ThomHPL/ScanBook_2017/Documentation/mecanique/images-structures/IMAG0920.jpg

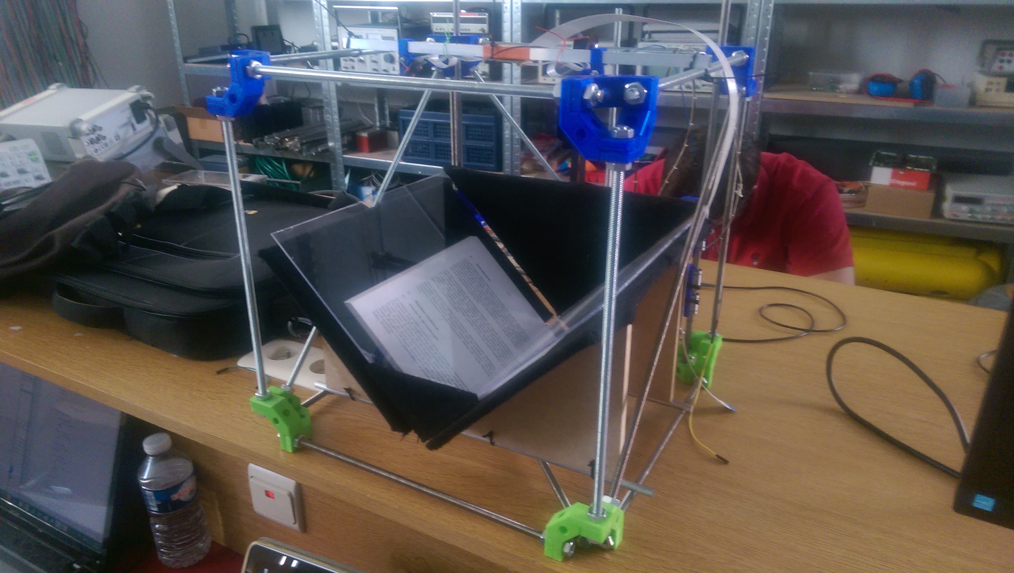
Documentation/mecanique/images-structures/IMAG0920.jpg
