ThomHPL/ScanBook_2017/Documentation/06_03/IMG_20170306_171104.jpg

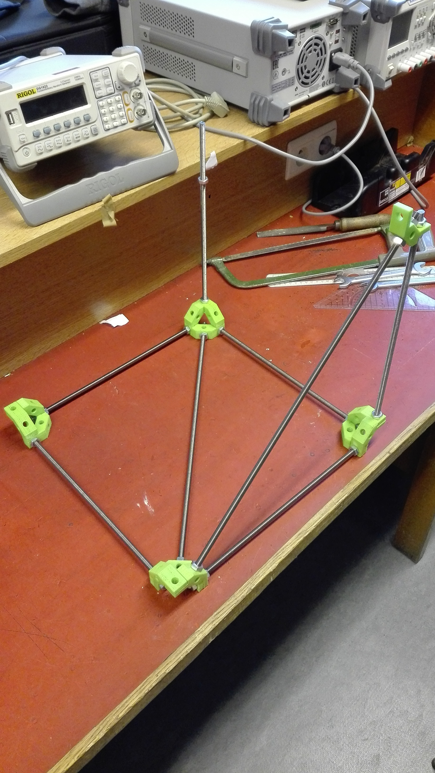
Documentation/06_03/IMG_20170306_171104.jpg
