ThomHPL/ScanBook_2017/Documentation/RF_SB_03_03_2017.docx

Projet et bureau d’étude

ScanBook

RedFlags

Thomas Herpoel – Wesley Estievenart – Michael Manzella

Work packages

WP | Description | Etat
SB_1 | Caméra : Choix, FOV, test,… | Green
SB_2 | Choix de la librairie de reconnaissance d’image et de l’algorithme (OCR) | Green
SB_3 | Programmation traitement des images | NC
SB_4 | Modification de la structure actuelle | Green
SB_5 | Conception d’un module de switch caméra (PCB) | Green
SB_6 | Circuit de protection (moteur pas à pas) | Green
SB_7 | Système d’éclairage indirect | NC
SB_8 | Programmation commande de moteur | Green
SB_9 | Interface homme machine | NC
SB_10 | Système d’alimentation | NC
SB_11 | Programmation Raspberry Pi (Configuration, Communication,…) | Yellow
