ThomHPL/ScanBook_2017/Documentation/03_03/renduHD.png

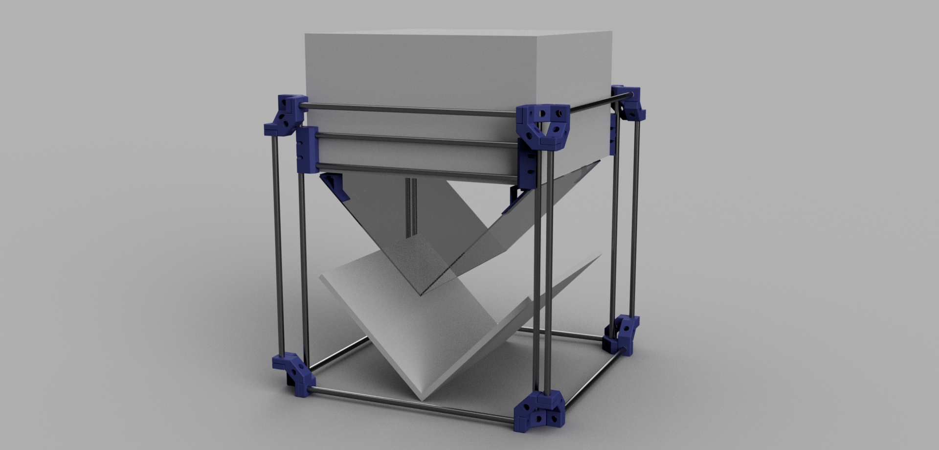
Documentation/03_03/renduHD.png
