ThomHPL/ScanBook_2017/Documentation/2017-03-28-133614_1920x1080_scrot.png

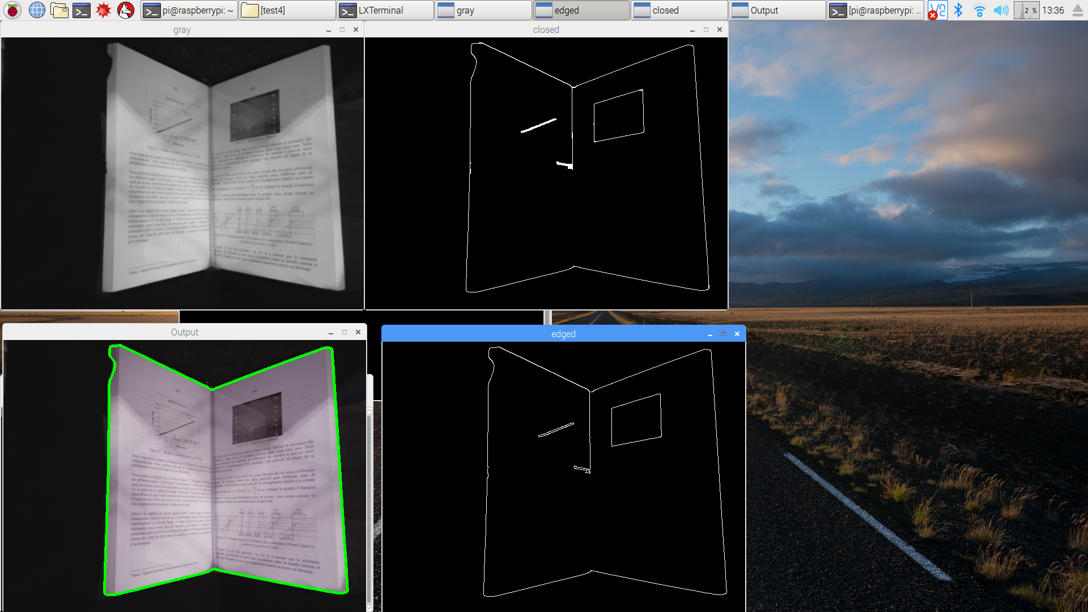
Documentation/2017-03-28-133614_1920x1080_scrot.png
