ThomHPL/ScanBook_2017/Documentation/electronique/A4988.PNG

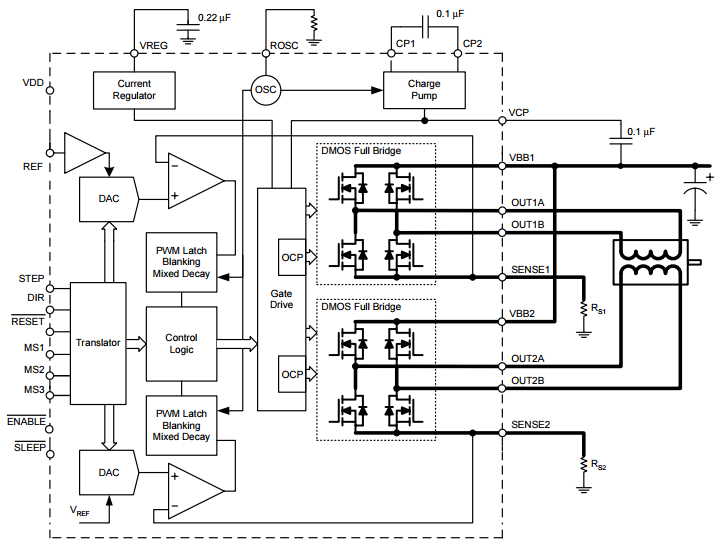
Documentation/electronique/A4988.PNG
