ThomHPL/ScanBook_2017/Documentation/electronique/PCB_top.PNG

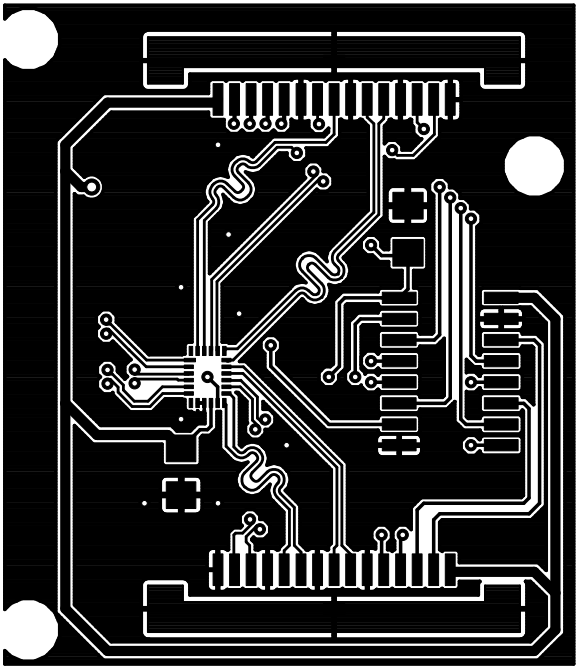
Documentation/electronique/PCB_top.PNG
