ThomHPL/ScanBook_2017/Documentation/mecanique/45_corner.PNG

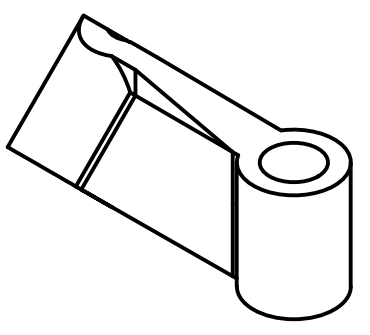
Documentation/mecanique/45_corner.PNG
