ThomHPL/ScanBook_2017/Documentation/mecanique/fin de course bas.PNG

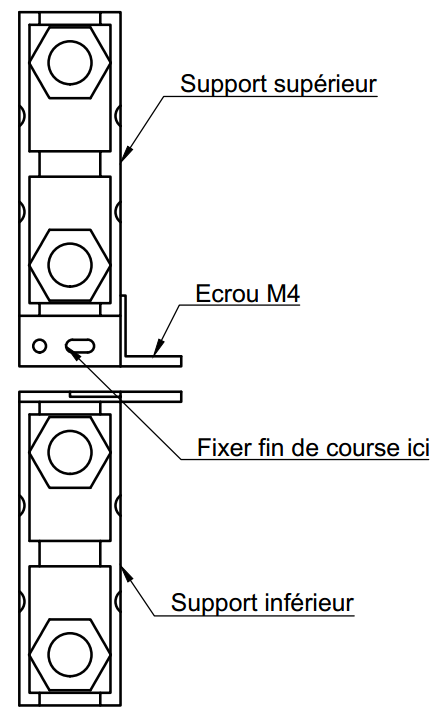
Documentation/mecanique/fin de course bas.PNG
