ThomHPL/ScanBook_2017/Documentation/mecanique/images-structures/IMAG0921.jpg

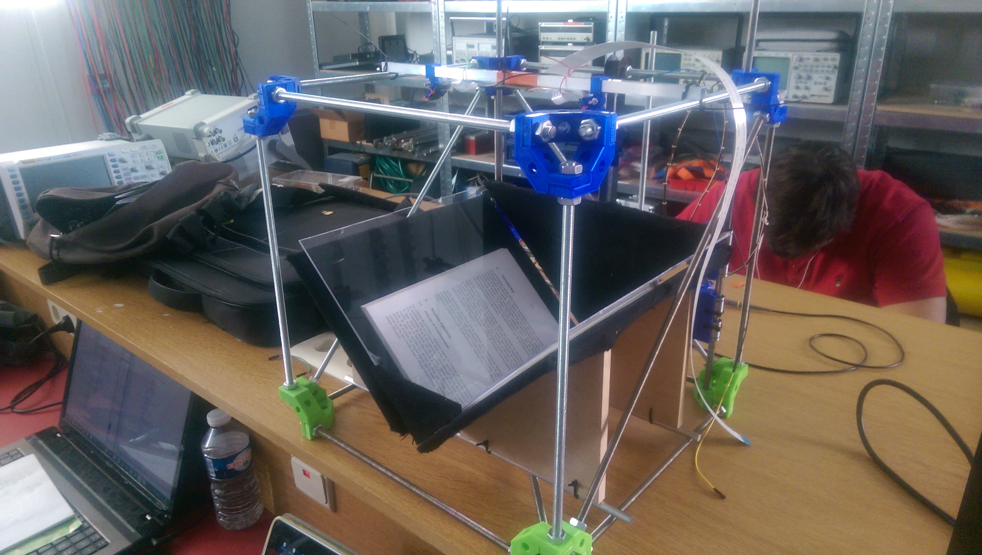
Documentation/mecanique/images-structures/IMAG0921.jpg
