ThomHPL/ScanBook_2017/Documentation/mecanique/images-structures/IMAG0922.jpg

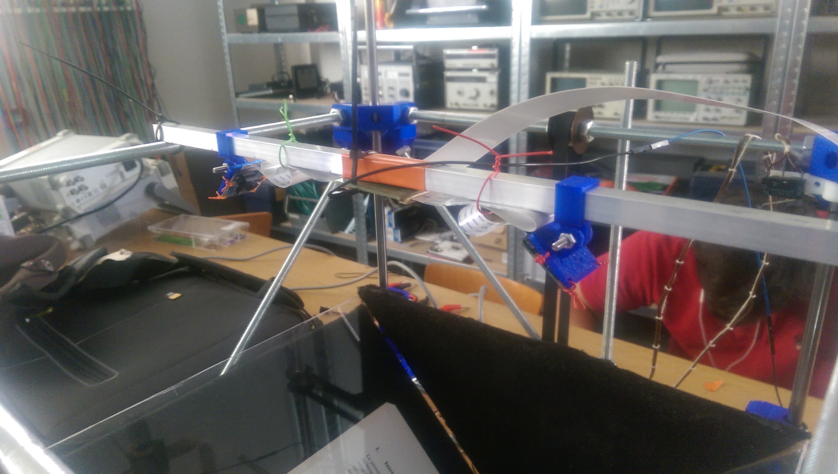
Documentation/mecanique/images-structures/IMAG0922.jpg
