ThomHPL/ScanBook_2017/Documentation/mecanique/images-structures/IMAG0923.jpg

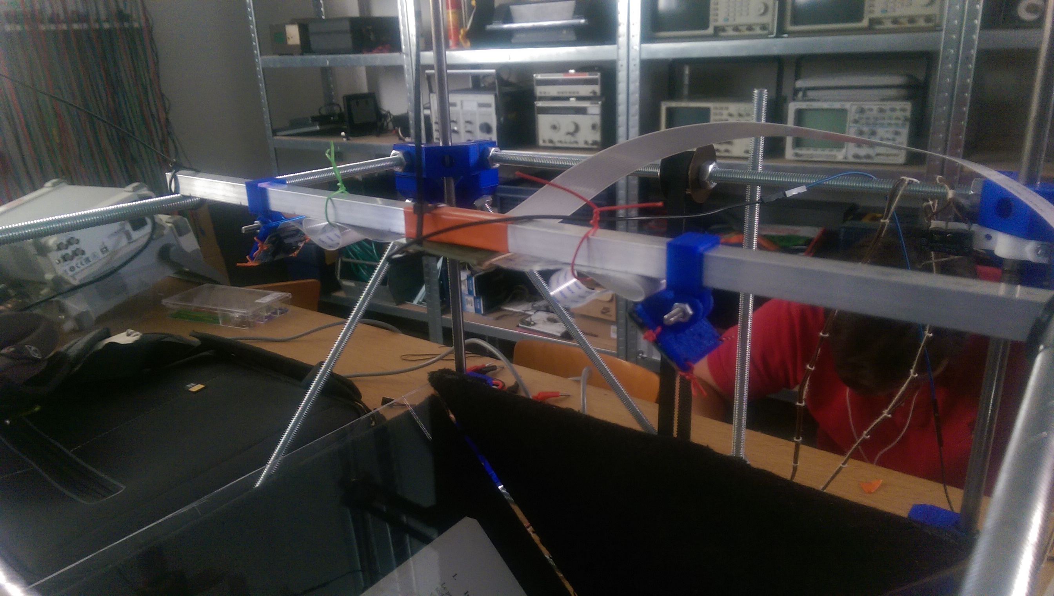
Documentation/mecanique/images-structures/IMAG0923.jpg
