ThomHPL/ScanBook_2017/Documentation/mecanique/images-structures/IMAG0924.jpg

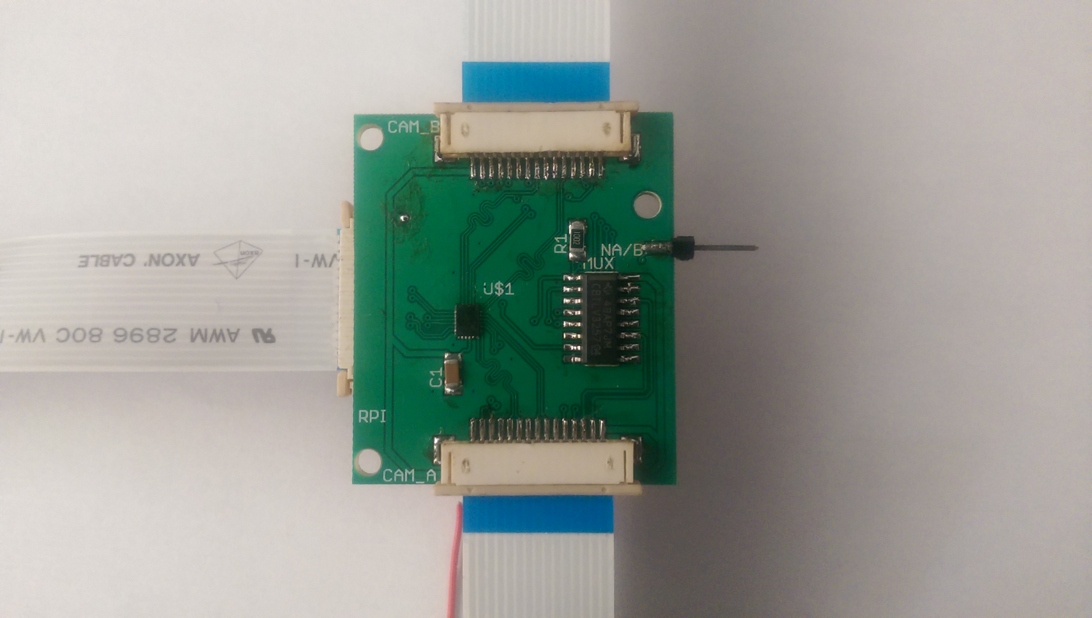
Documentation/mecanique/images-structures/IMAG0924.jpg
