ThomHPL/ScanBook_2017/Documentation/mecanique/images-structures/IMAG0925.jpg

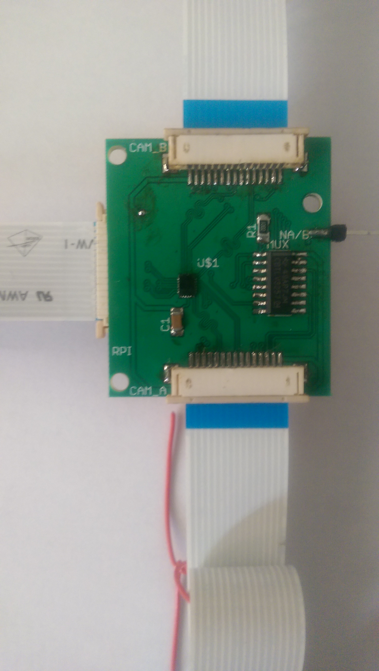
Documentation/mecanique/images-structures/IMAG0925.jpg
