ThomHPL/ScanBook_2017/Documentation/mecanique/images-structures/IMAG0926.jpg

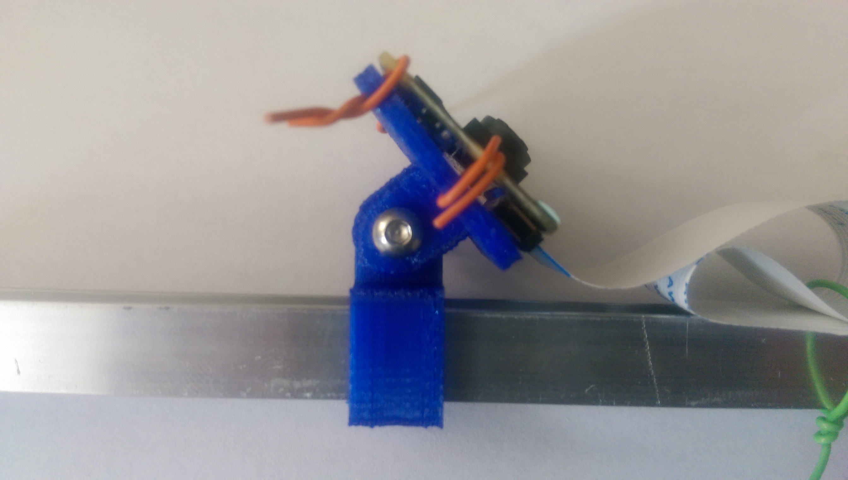
Documentation/mecanique/images-structures/IMAG0926.jpg
