ThomHPL/ScanBook_2017/Documentation/mecanique/images-structures/IMAG0927.jpg

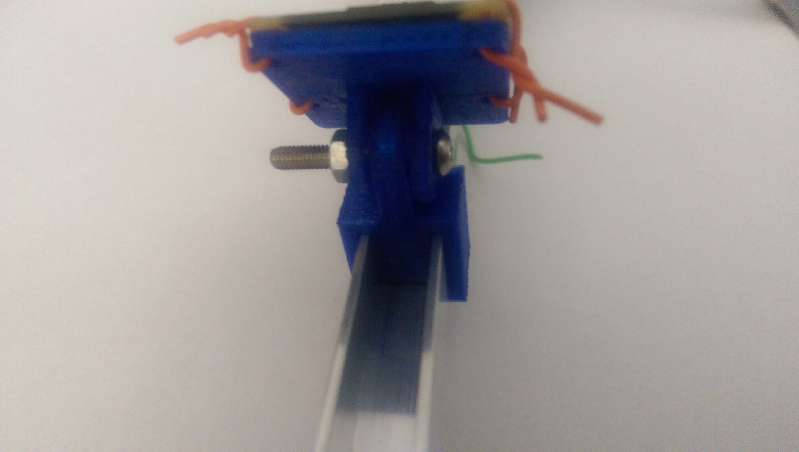
Documentation/mecanique/images-structures/IMAG0927.jpg
