ThomHPL/ScanBook_2017/Documentation/mecanique/images-structures/IMAG0928.jpg

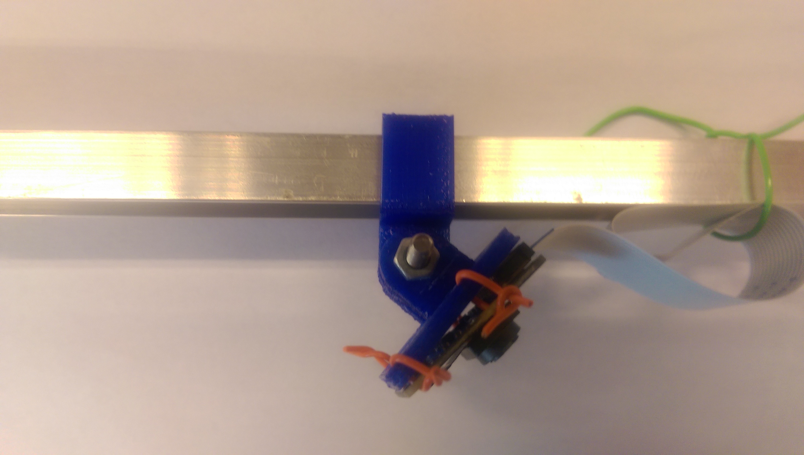
Documentation/mecanique/images-structures/IMAG0928.jpg
