ThomHPL/ScanBook_2017/Documentation/mecanique/motor_support.PNG

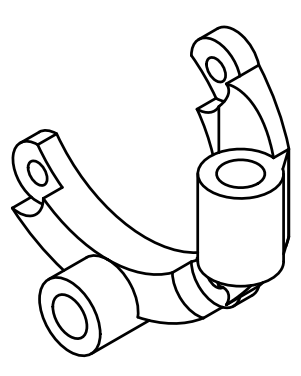
Documentation/mecanique/motor_support.PNG
