ThomHPL/ScanBook_2017/Documentation/mecanique/rendu_face.png

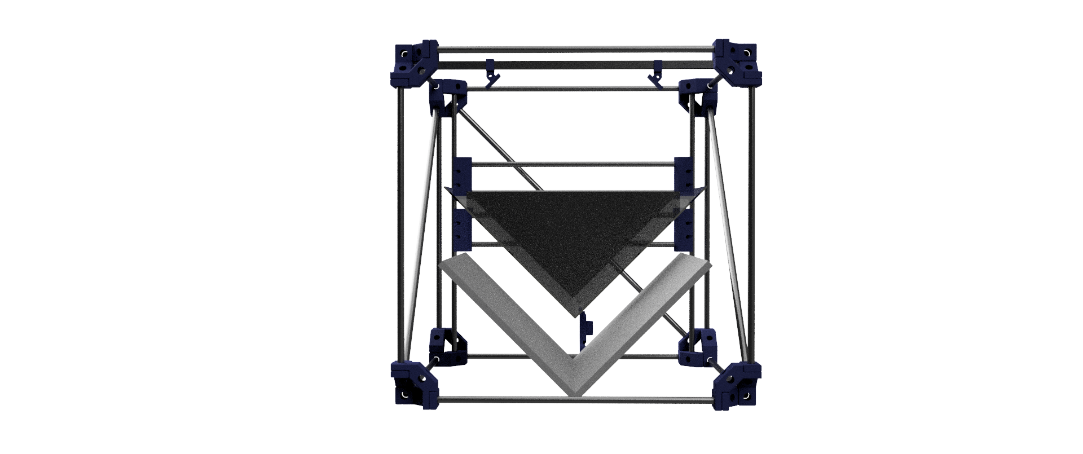
Documentation/mecanique/rendu_face.png
