ThomHPL/ScanBook_2017/Documentation/mecanique/rendu_oblique.png

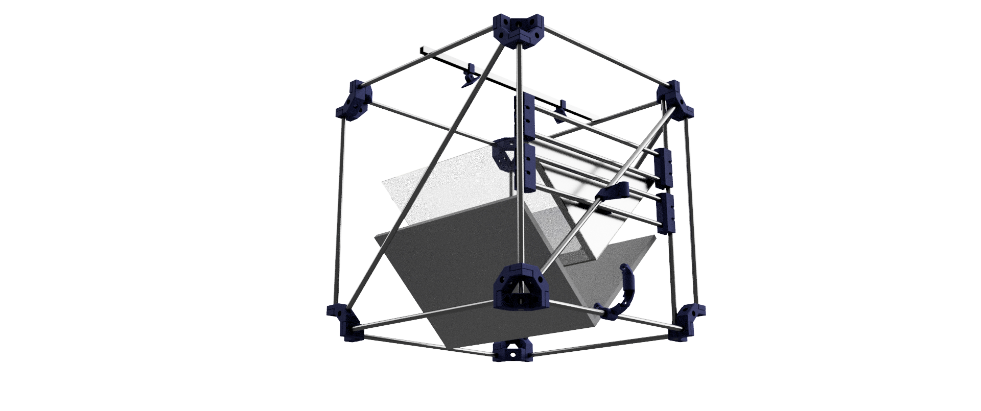
Documentation/mecanique/rendu_oblique.png
