ThomHPL/ScanBook_2017/Documentation/pcb_bottom.PNG

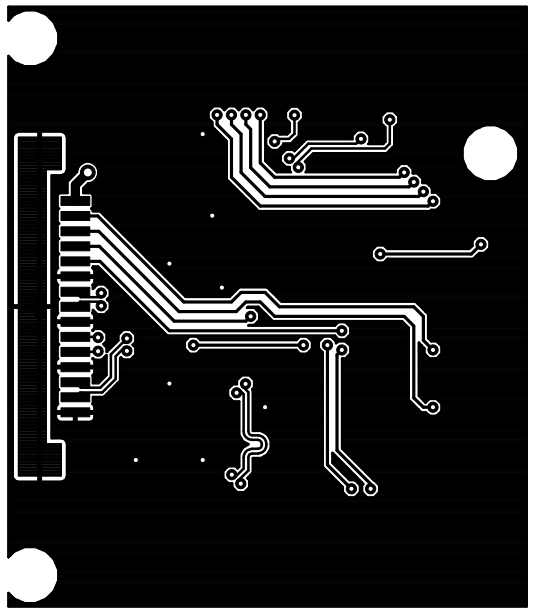
Documentation/pcb_bottom.PNG
