ThomHPL/ScanBook_2017/Documentation/switch_schematic.PNG

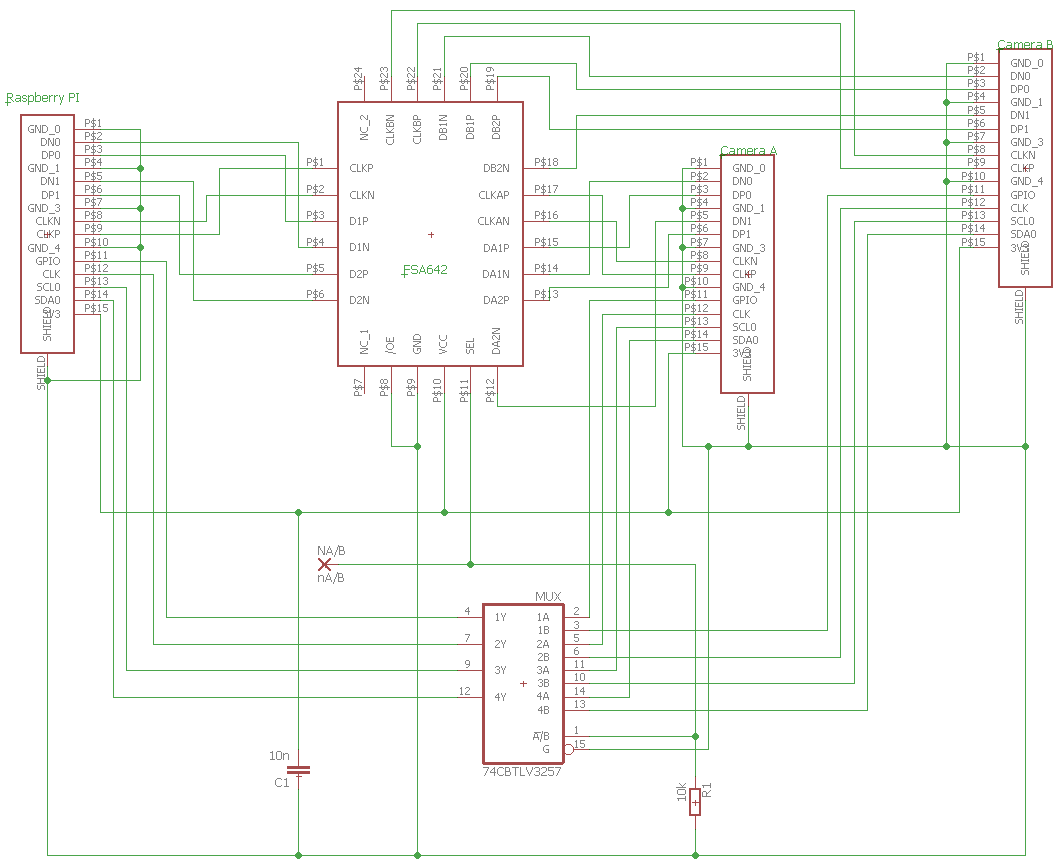
Documentation/switch_schematic.PNG
