ThomHPL/ScanBook_2017/Documentation/corner.stl

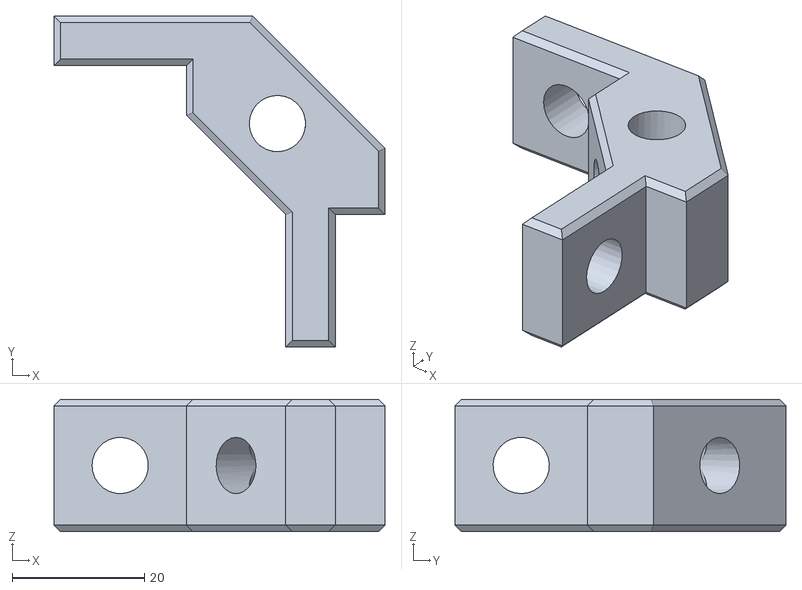
[picture p78: CAD file, 2017-03-08]
Documentation/corner.stl
50.0 x 50.0 x 20.0
