ThomHPL/ScanBook_2017/STL/cam_support_B.stl

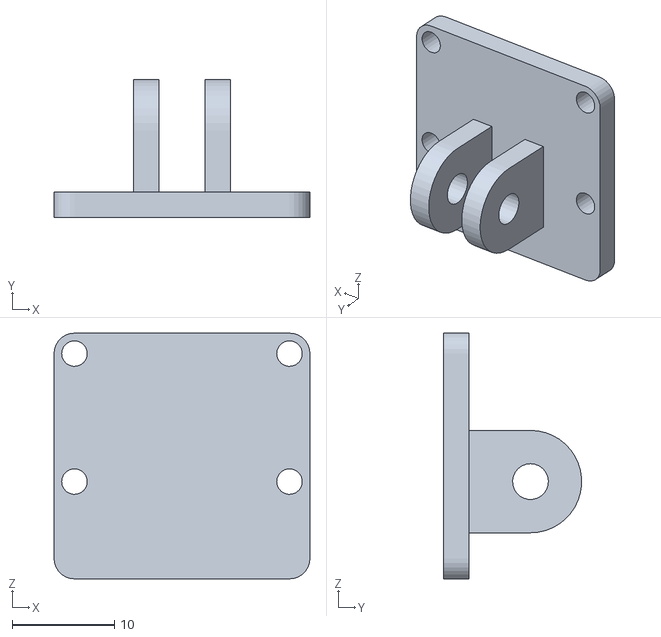
[picture p79: CAD file, 2017-04-10]
STL/cam_support_B.stl
25.0 x 13.5 x 24.0
