ThomHPL/ScanBook_2017/STL/cam_support_A.stl

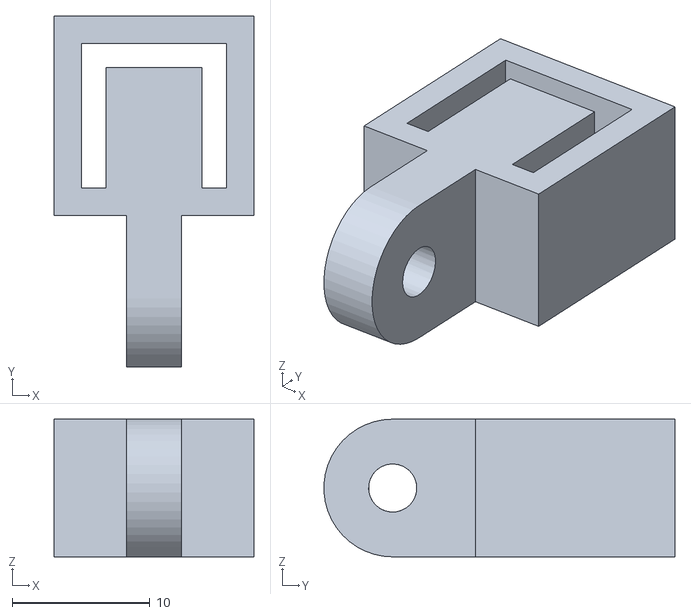
[picture p80: CAD file, 2017-04-10]
STL/cam_support_A.stl
14.5 x 25.5 x 10.0
