ThomHPL/ScanBook_2017/STL/spring_mecanism_A_R.stl

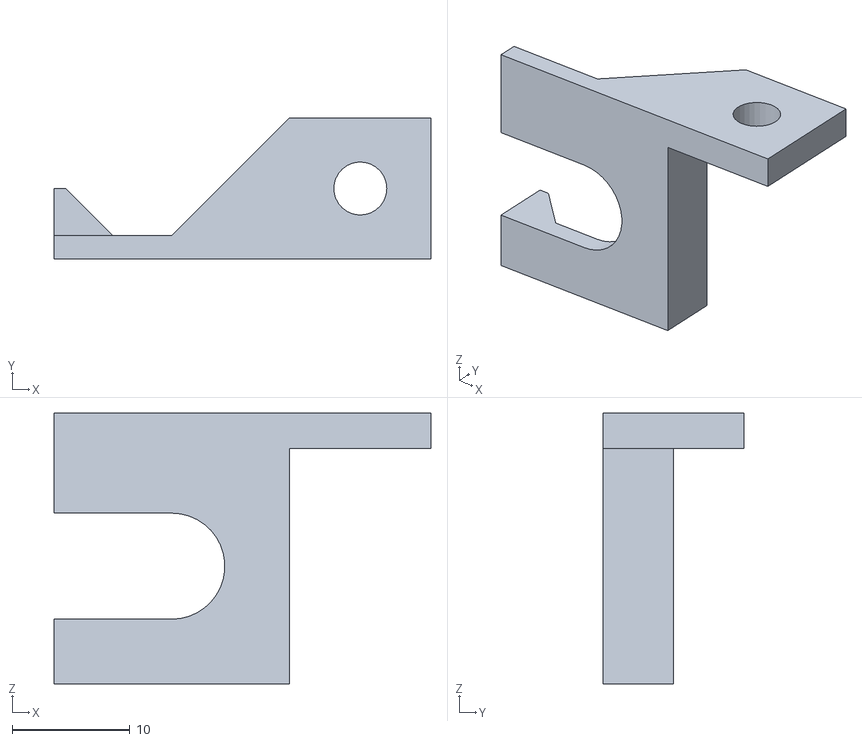
[picture p81: CAD file, 2017-03-28]
STL/spring_mecanism_A_R.stl
32.0 x 12.0 x 23.0
