ThomHPL/ScanBook_2017/STL/bar_fix.stl

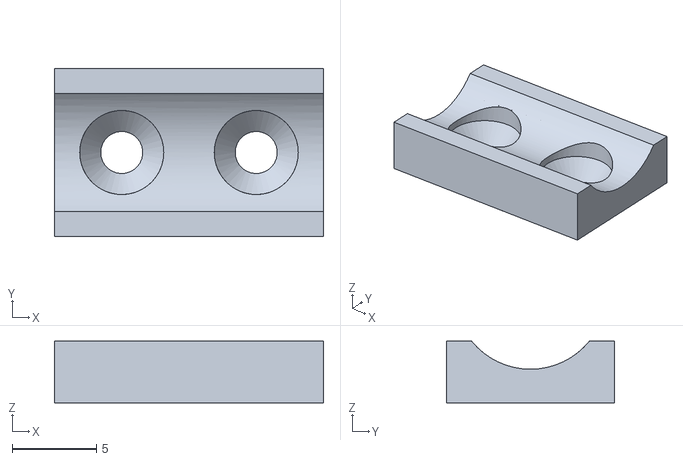
[picture p82: CAD file, 2017-03-28]
STL/bar_fix.stl
16.0 x 10.0 x 3.67
