ThomHPL/ScanBook_2017/STL/spring_mecanism_B_R.stl

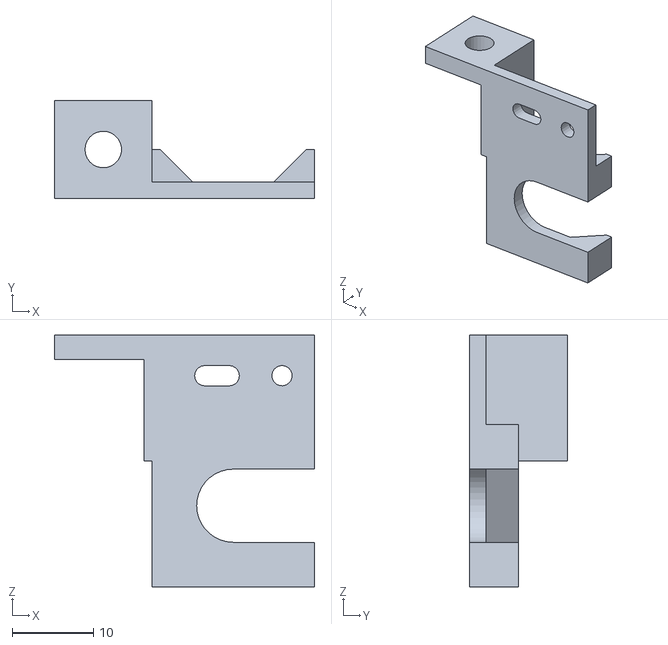
[picture p83: CAD file, 2017-03-28]
STL/spring_mecanism_B_R.stl
32.0 x 12.0 x 31.0
