ThomHPL/ScanBook_2017/STL/carriage_support.stl

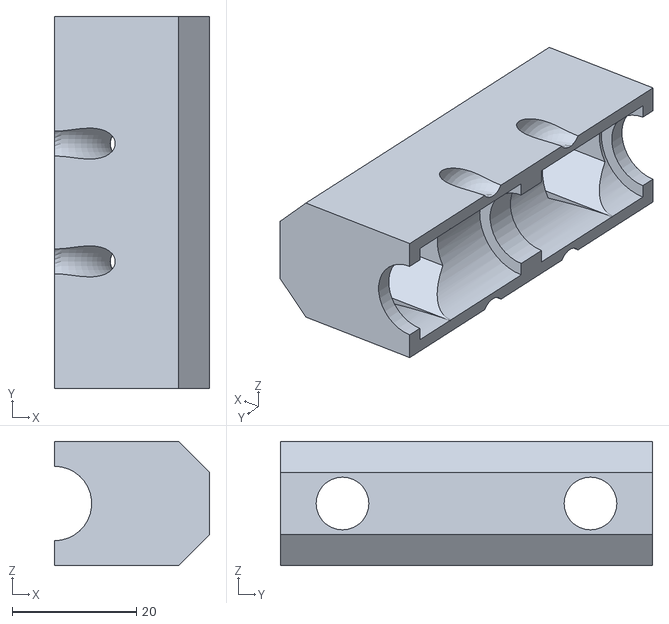
[picture p84: CAD file, 2017-03-28]
STL/carriage_support.stl
25.0 x 60.0 x 20.0
