ThomHPL/ScanBook_2017/(list of files, cad)

Other CAD files:
STL/spring_mecanism_B_L.stl
STL/spring_mecanism_A_L.stl
