ThomHPL/ScanBook_2017/Documentation/mecanique/assemblage coin.PNG

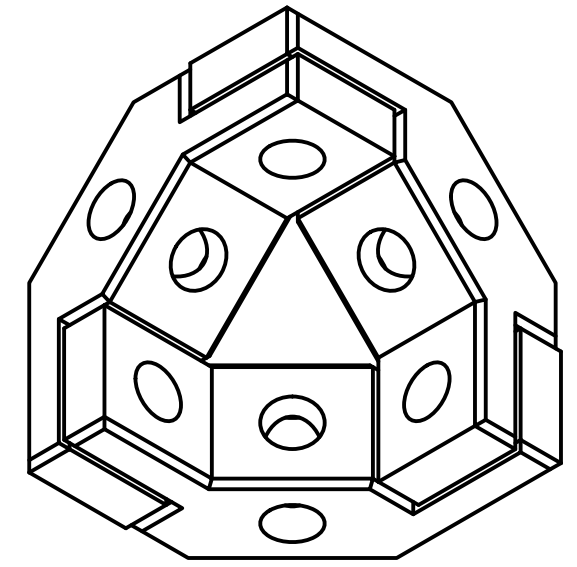
Documentation/mecanique/assemblage coin.PNG
