ThomHPL/ScanBook_2017/Documentation/mecanique/assemblage.PNG

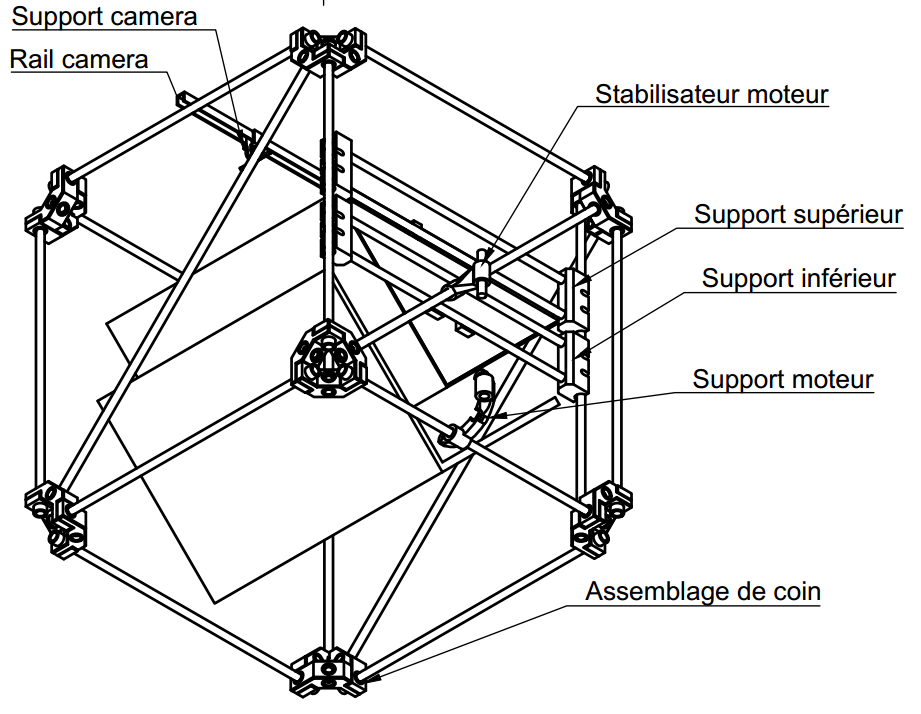
Documentation/mecanique/assemblage.PNG
