ThomHPL/ScanBook_2017/Documentation/mecanique/assemblage_Sheet1_Sheet1.pdf

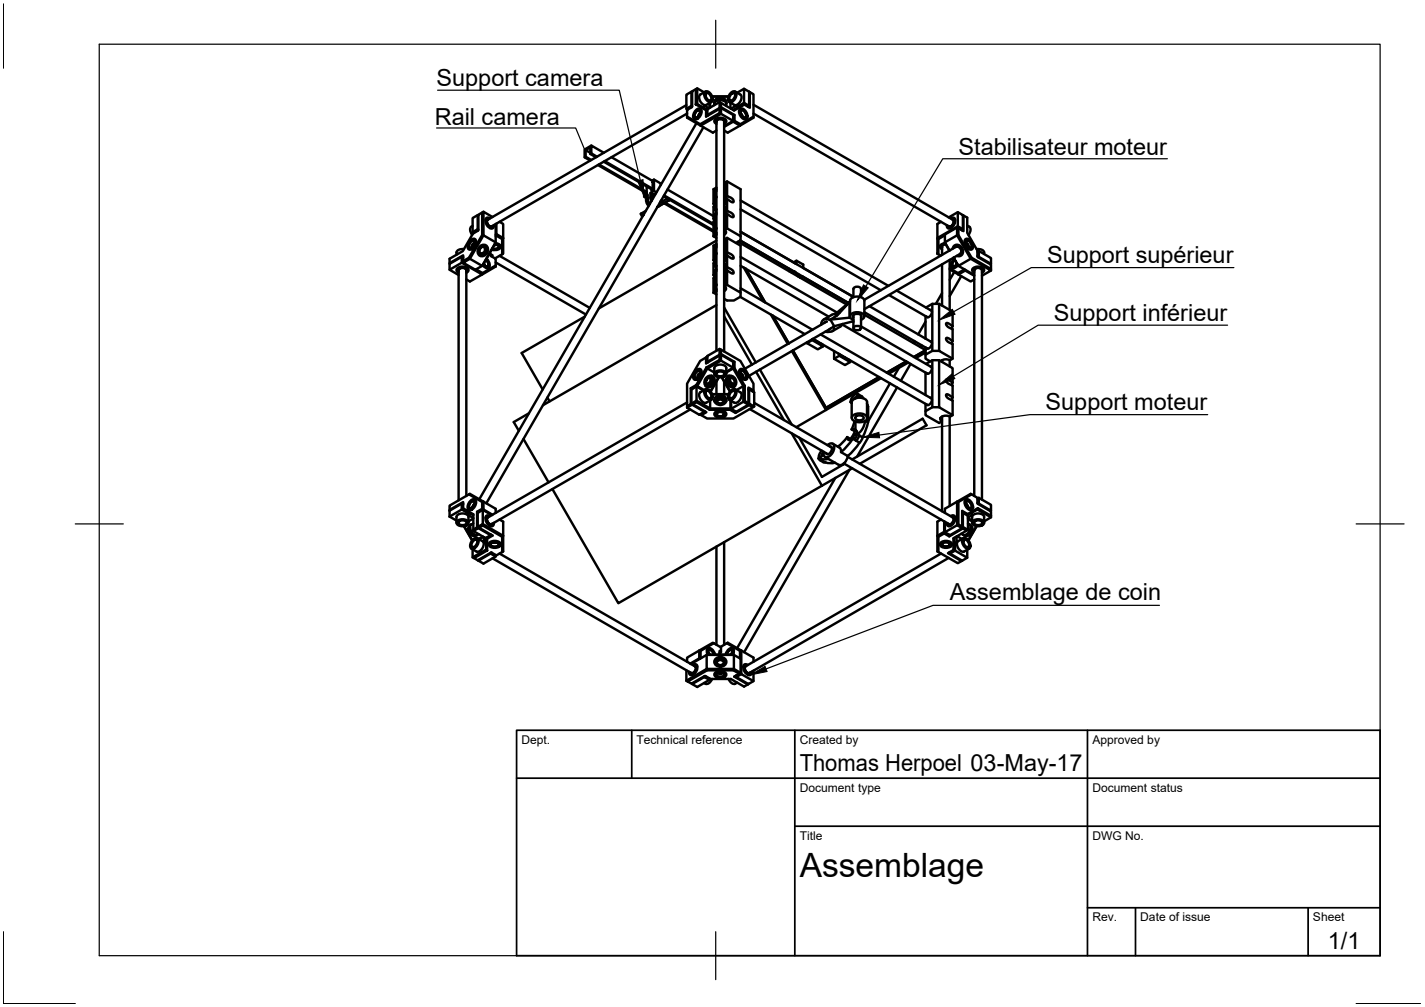
[picture p87: page 1]
Support supérieur; Support inférieur; Stabilisateur moteur; Support moteur; Support camera; Rail camera

Assemblage de coin

Dept. | Technical reference | Created by Thomas Herpoel 03-May-17 | Approved by

Document type | Document status

Title Assemblage | DWG No.

Rev. | Date of issue | Sheet 1/1
