ThomHPL/ScanBook_2017/Documentation/mecanique/motor_support.pdf

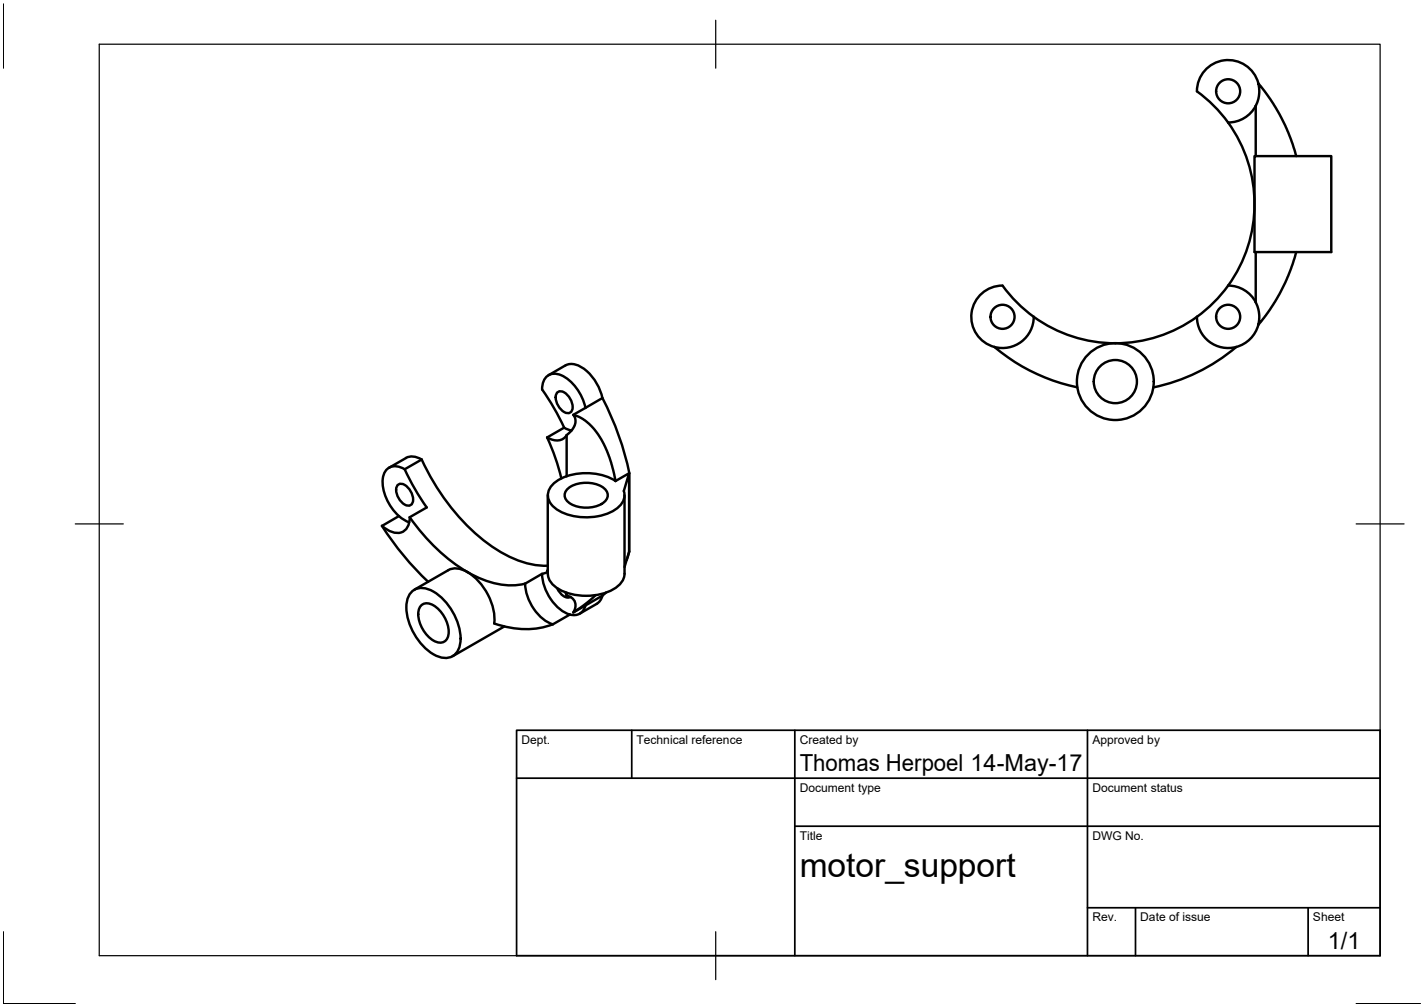
[picture p88: page 1]

Dept. | Technical reference | Created by Thomas Herpoel 14-May-17 | Approved by

Document type | Document status

Title motor_support | DWG No.

Rev. | Date of issue | Sheet 1/1
