ThomHPL/ScanBook_2017/Documentation/mecanique/assemblage_coin_Sheet1.pdf

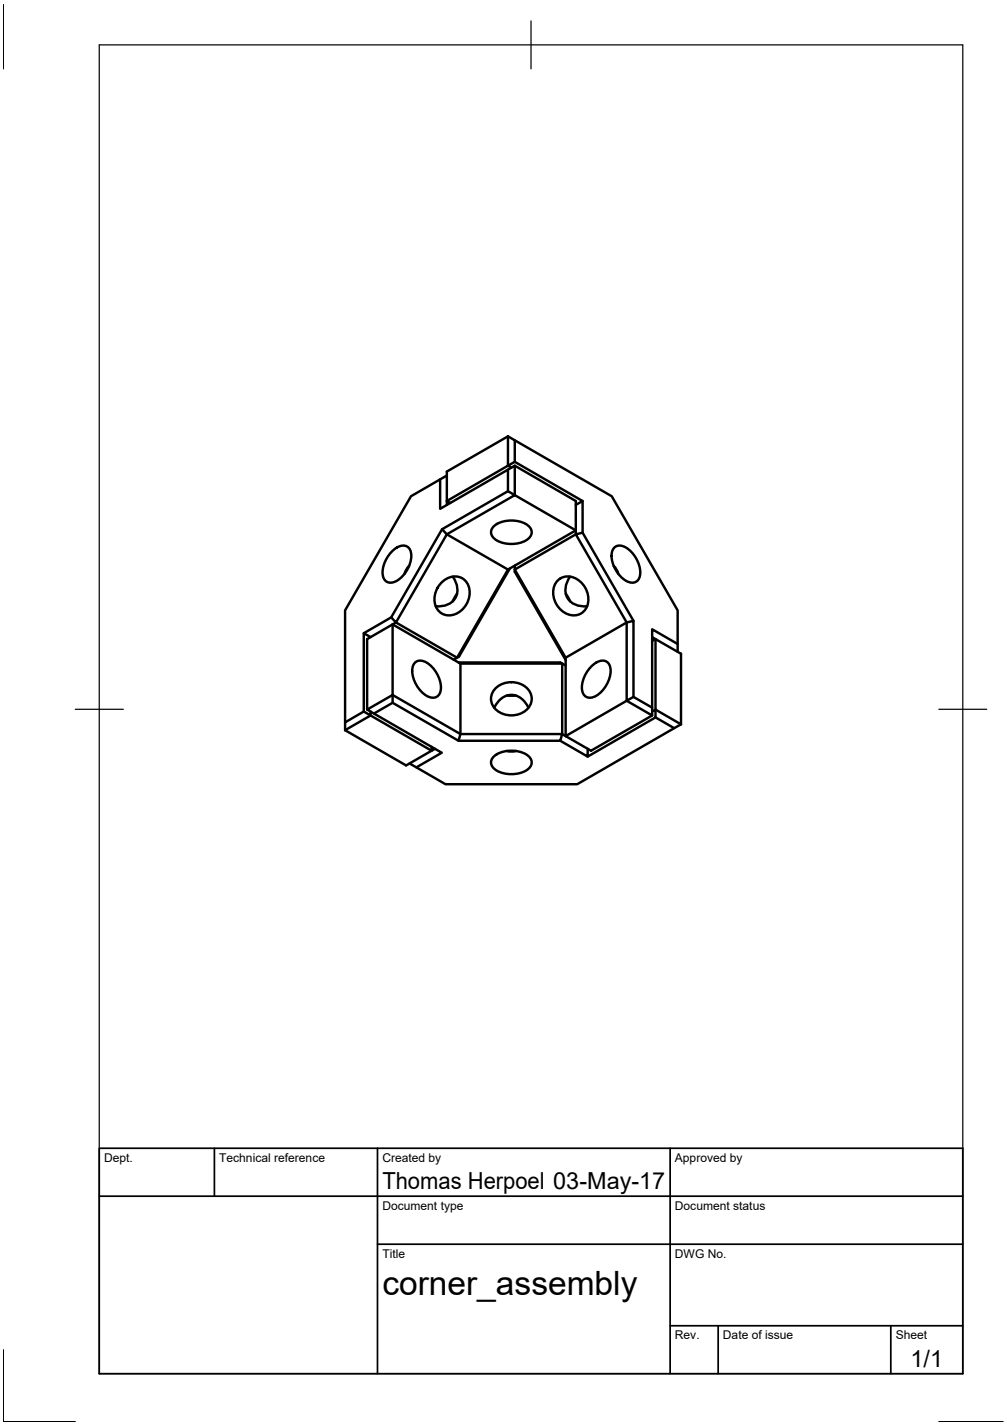
[picture p89: page 1]

Dept. | Technical reference | Created by Thomas Herpoel 03-May-17 | Approved by

Document type | Document status

Title corner_assembly | DWG No.

Rev. | Date of issue | Sheet 1/1
