ThomHPL/ScanBook_2017/Documentation/mecanique/cam_assembly_Sheet1.pdf

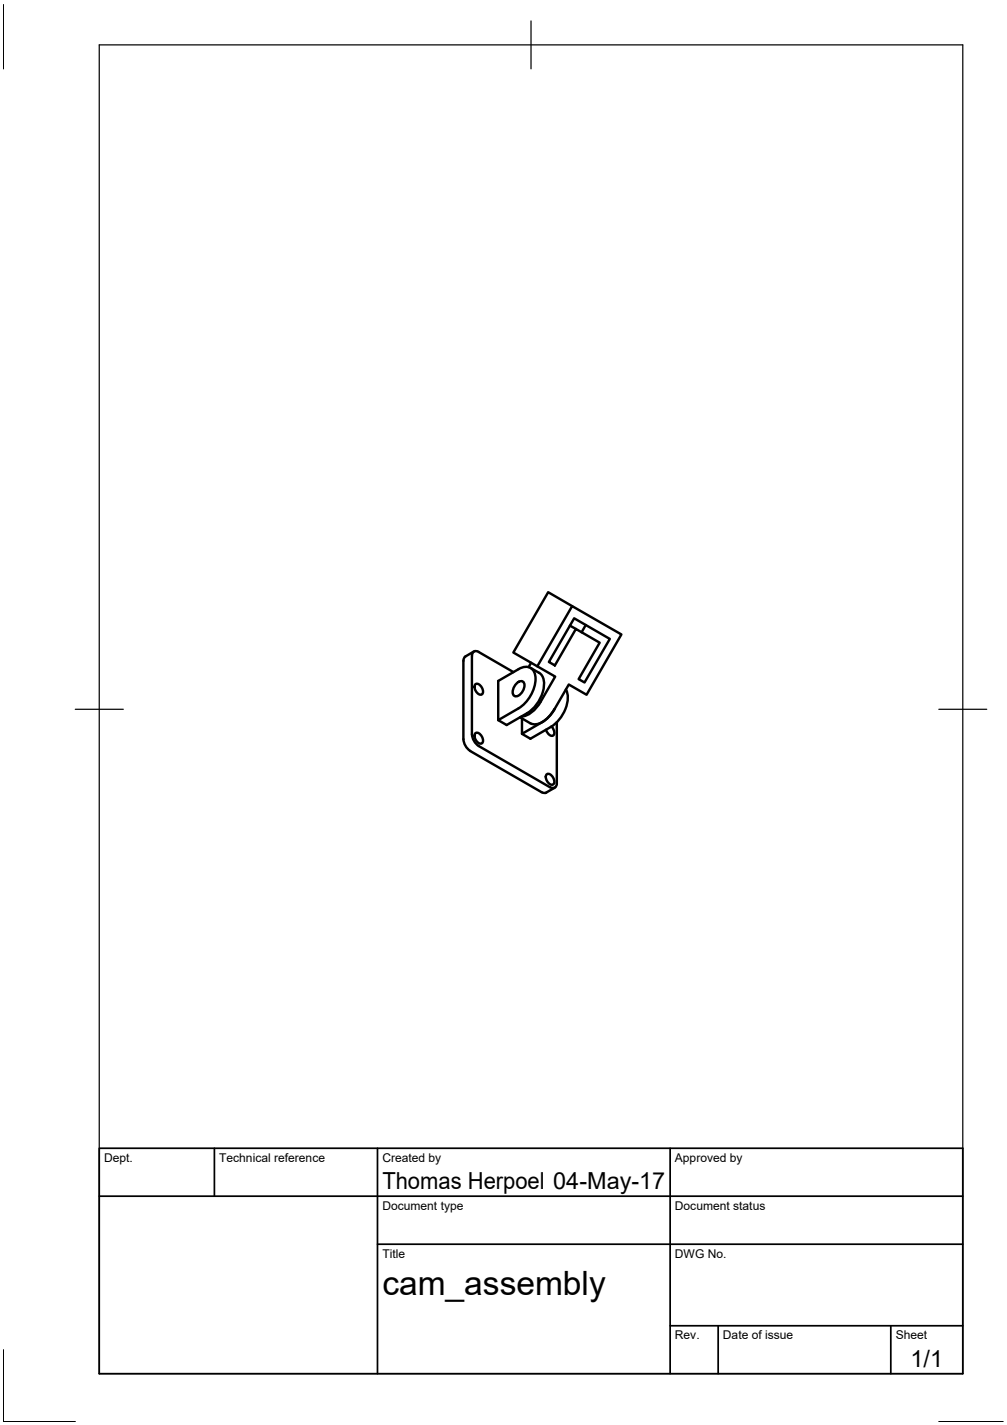
[picture p90: page 1]

Dept. | Technical reference | Created by Thomas Herpoel 04-May-17 | Approved by

Document type | Document status

Title cam_assembly | DWG No.

Rev. | Date of issue | Sheet 1/1
