ThomHPL/ScanBook_2017/Documentation/circuit_bottom.pdf

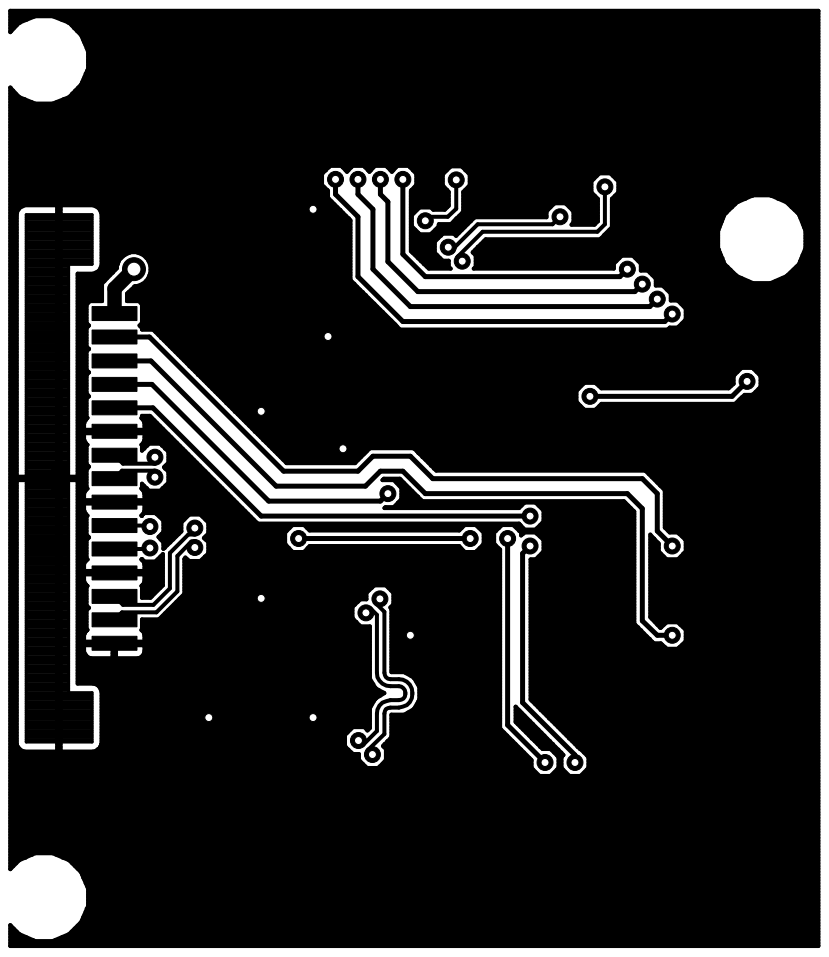
[picture p91: page 1]
