ThomHPL/ScanBook_2017/Documentation/circuit_top.pdf

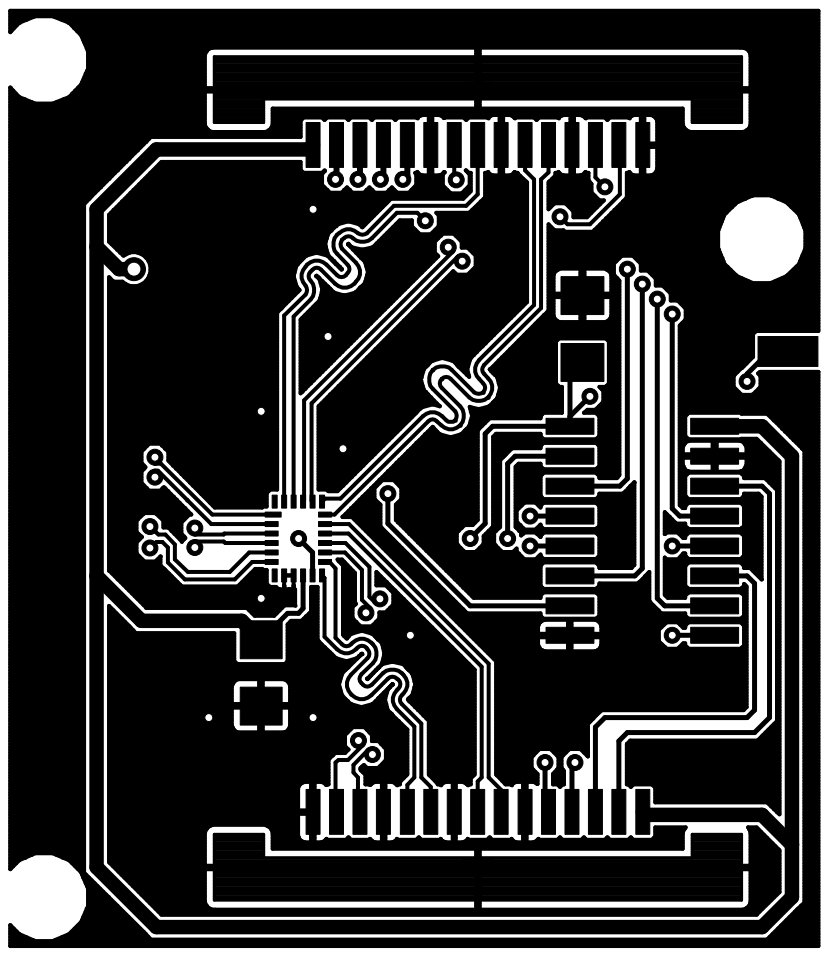
[picture p92: page 1]
