ThomHPL/ScanBook_2017/Documentation/electronique/circuit_bottom.pdf

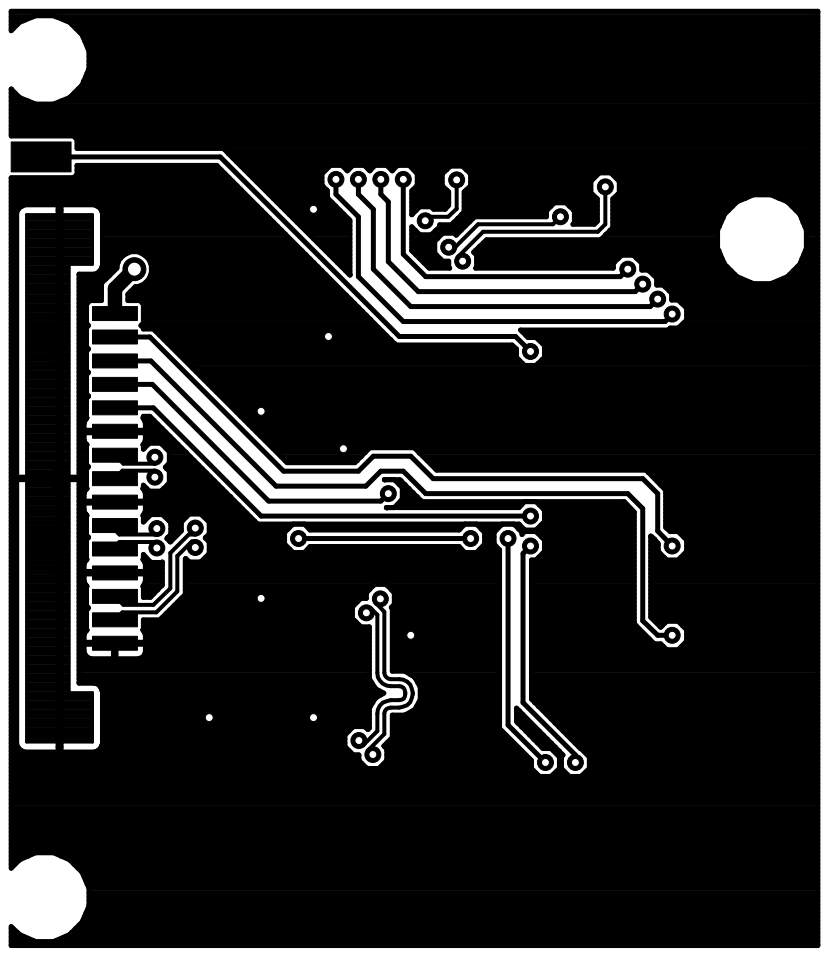
[picture p93: page 1]
