ThomHPL/ScanBook_2017/Documentation/electronique/circuit_bottom_rev.pdf

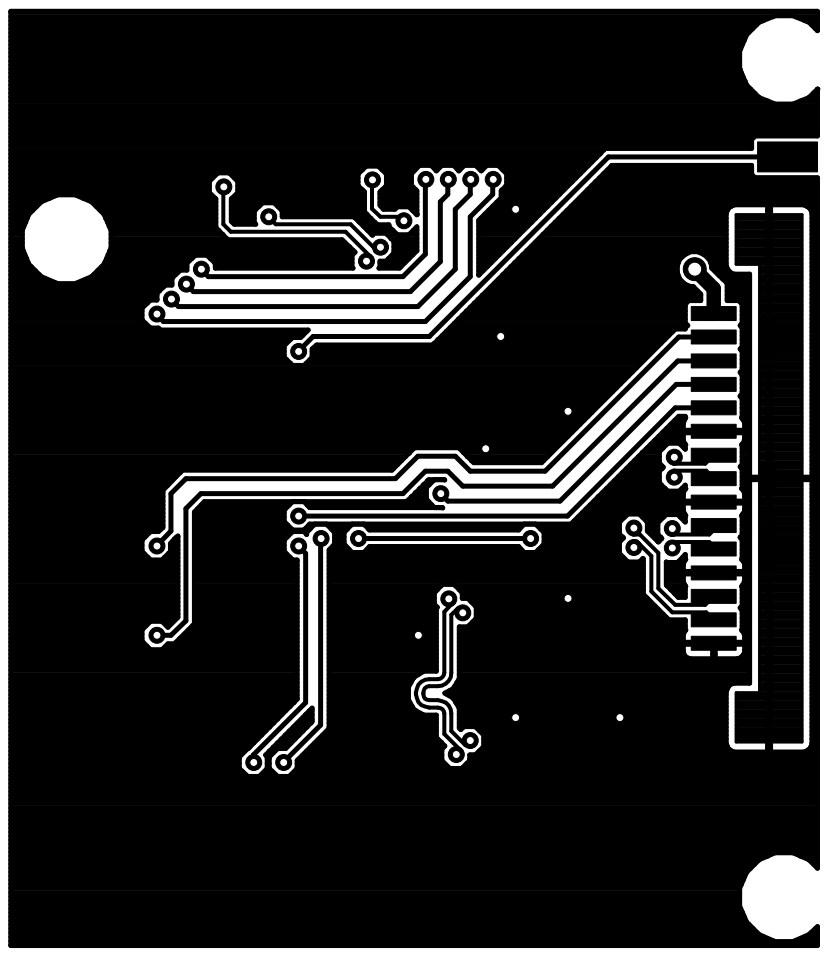
[picture p94: page 1]
