ThomHPL/ScanBook_2017/Documentation/electronique/circuit_top.pdf

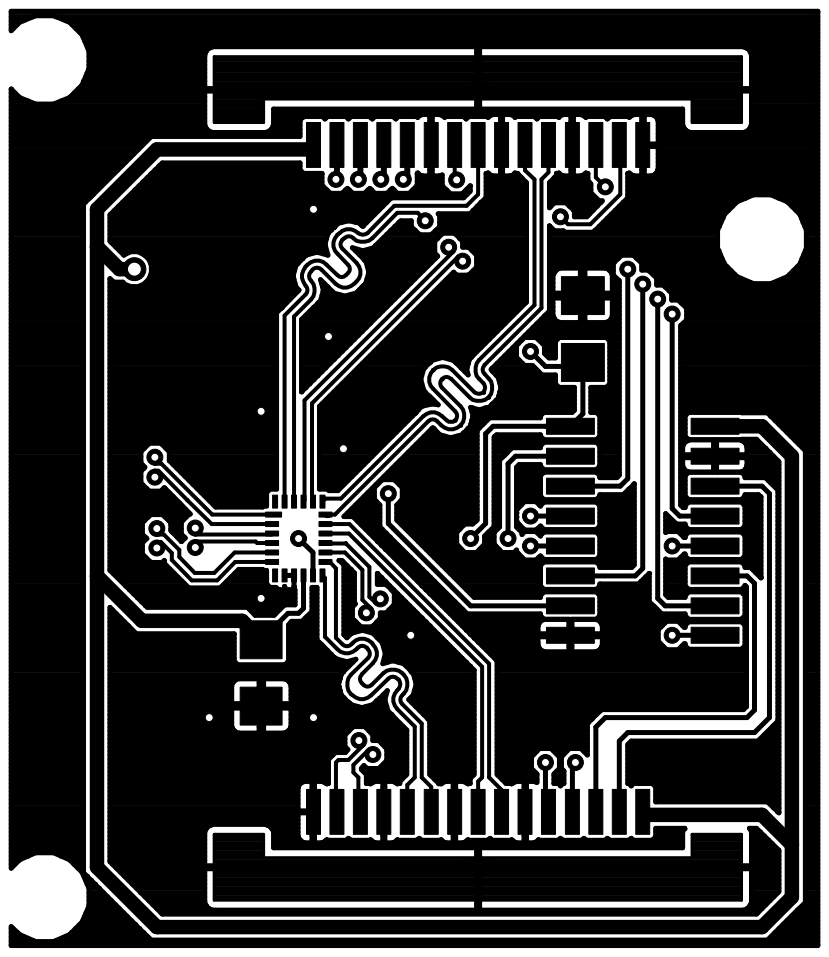
[picture p95: page 1]
