ThomHPL/ScanBook_2017/Documentation/electronique/PiCam_Switch_1.2.pdf

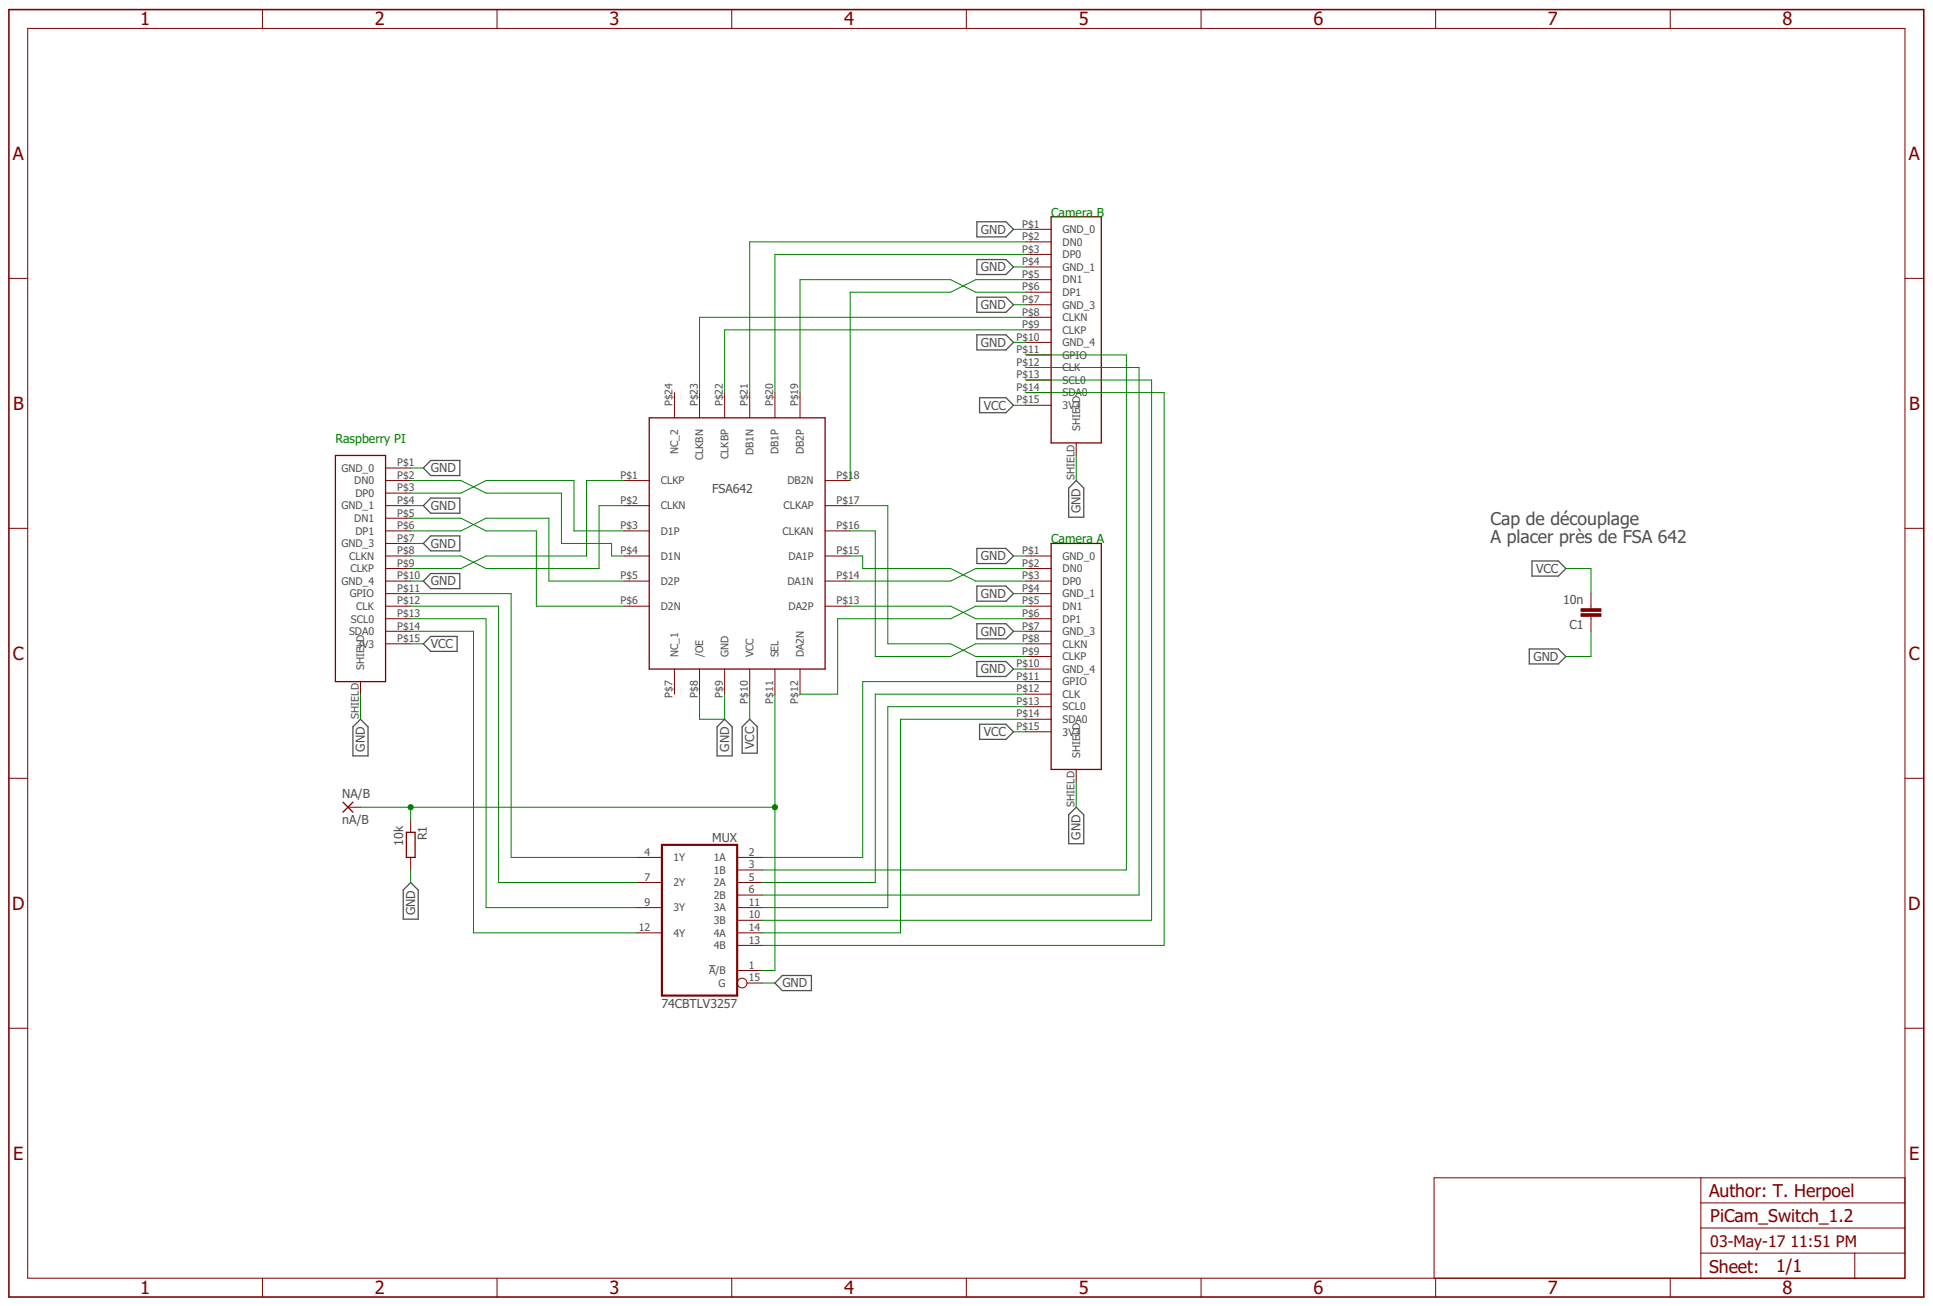
[picture p96: page 1]
