ThomHPL/ScanBook_2017/Documentation/mecanique/45_corner.pdf

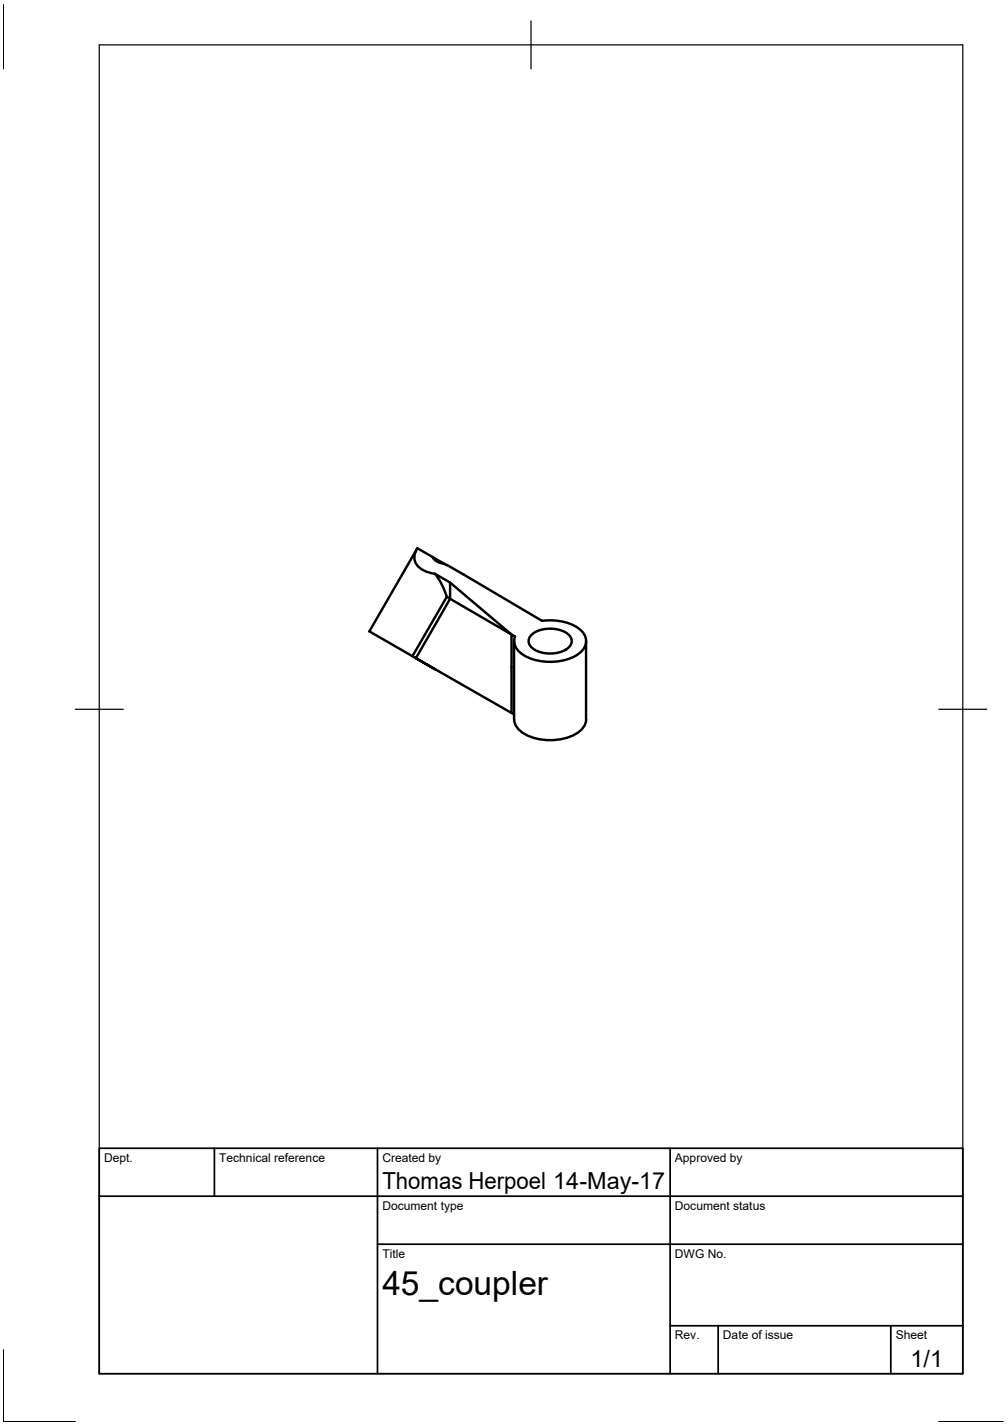
[picture p97: page 1]

Dept. | Technical reference | Created by Thomas Herpoel 14-May-17 | Approved by

Document type | Document status

Title 45_coupler | DWG No.

Rev. | Date of issue | Sheet 1/1
