ThomHPL/ScanBook_2017/Documentation/mecanique/fin de course bas_Sheet1_Sheet1.pdf

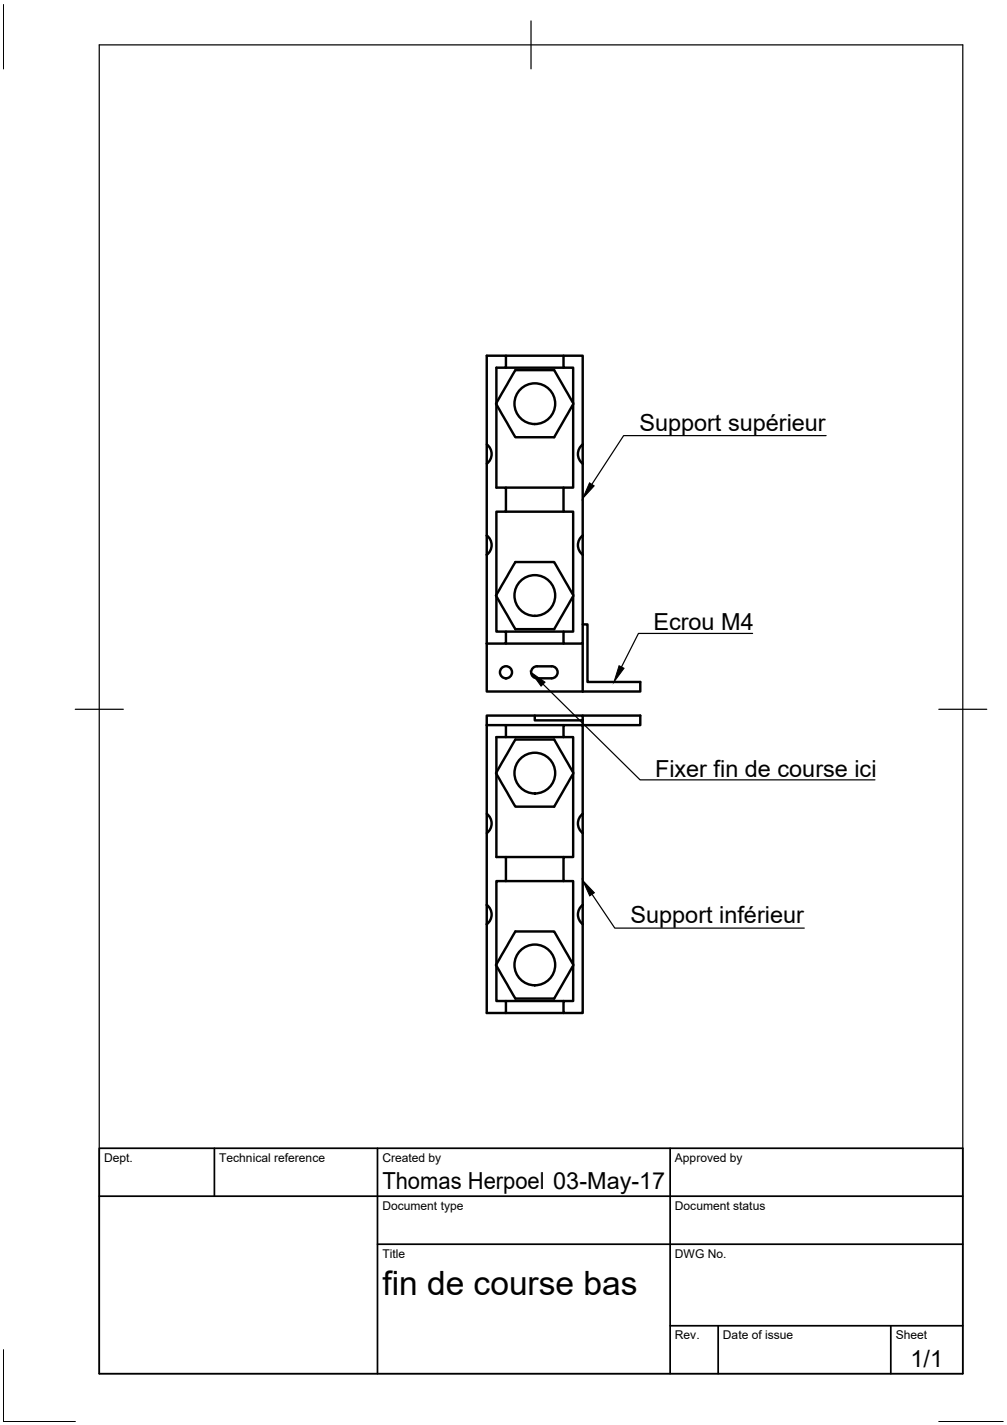
[picture p98: page 1]
Ecrou M4; Support supérieur; Support inférieur

Fixer fin de course ici

Dept. | Technical reference | Created by Thomas Herpoel 03-May-17 | Approved by

Document type | Document status

Title fin de course bas | DWG No.

Rev. | Date of issue | Sheet 1/1
