ThomHPL/ScanBook_2017/Documentation/mecanique/module_Sheet1.pdf

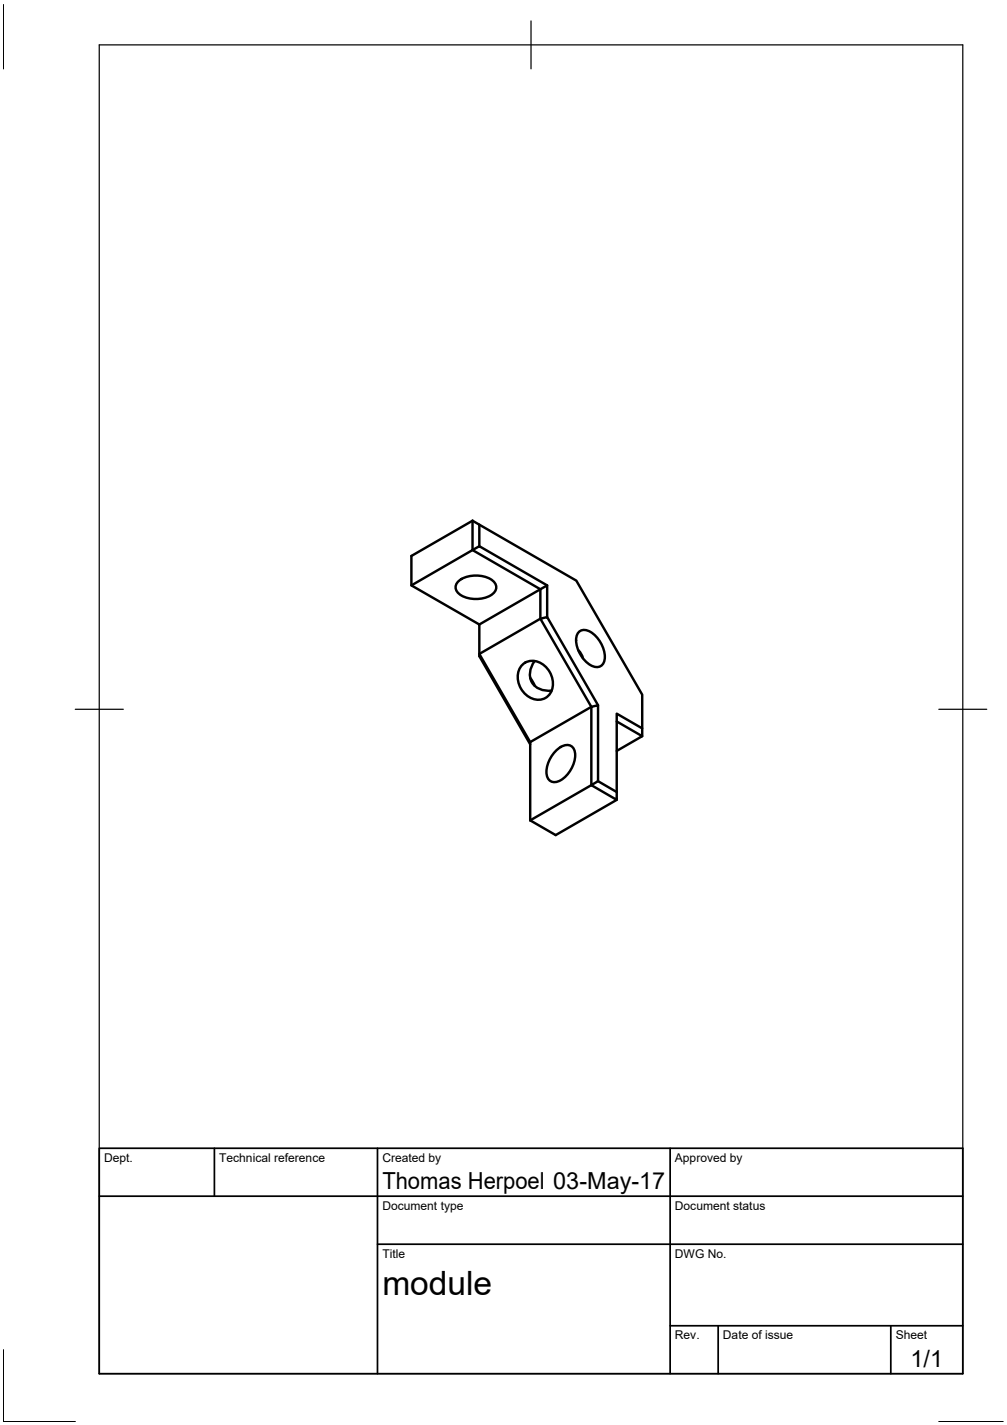
[picture p99: page 1]

Dept. | Technical reference | Created by Thomas Herpoel 03-May-17 | Approved by

Document type | Document status

Title module | DWG No.

Rev. | Date of issue | Sheet 1/1
