ThomHPL/ScanBook_2017/Documentation/electronique/Carte micro 2017/bottom.pdf

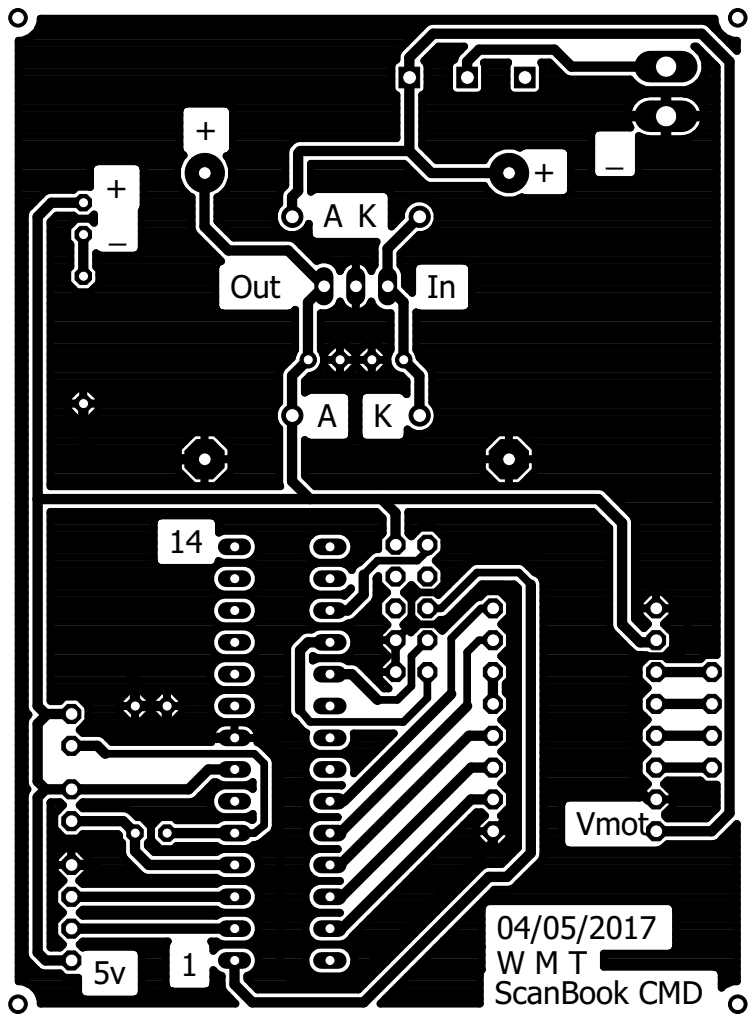
[picture p100: page 1]
