ThomHPL/ScanBook_2017/Documentation/electronique/Carte micro 2017/ScanBook.brd

## EAGLE design Documentation/electronique/Carte micro 2017/ScanBook.brd (2017-05-15)

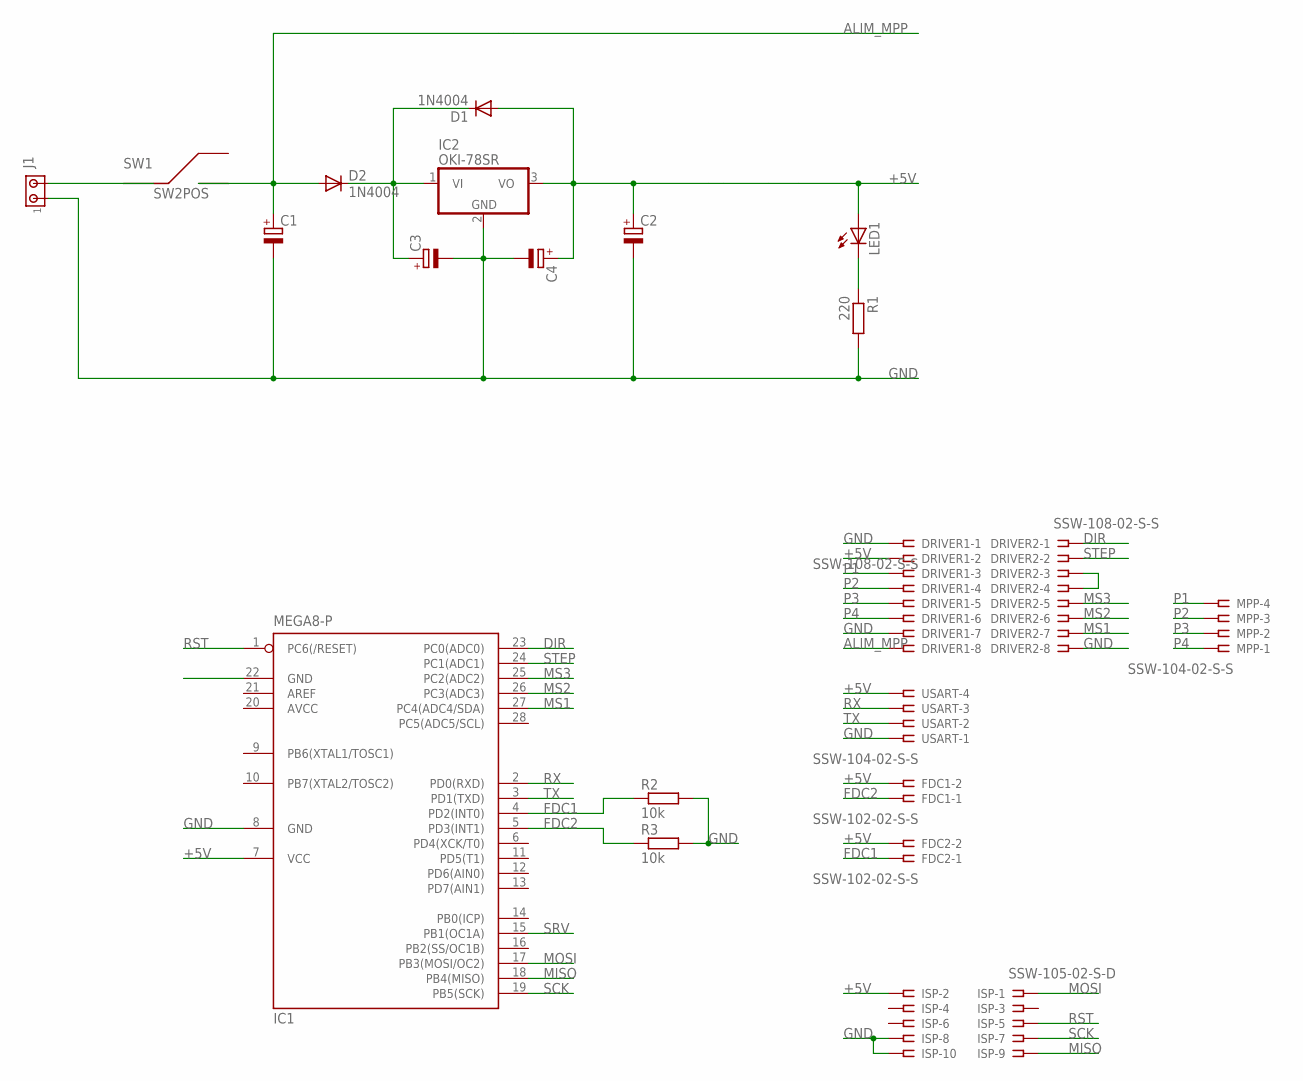
[picture p101: schematic ScanBook.sch]

Parts:
C1, C2: CPOL-EUE22-9AXIAL; E22-9
C3, C4: CPOL-EUTT2D4; TT2D4
D1, D2: 1N4004; DO41-10
DRIVER1, DRIVER2: SSW-108-02-S-S
FDC1, FDC2: SSW-102-02-S-S
IC1: MEGA8-P; DIL28-3
IC2: OKI-78SR; TO220V
ISP: SSW-105-02-S-D
J1: MTA02-156; 1X2MTA
LED1: LED3MM
MPP: SSW-104-02-S-S
R1: 220; 0207/10
R2, R3: 10k; 0207/10
SW1: SW2POS
USART: SSW-104-02-S-S

Connections:
+5V: C2.+, C4.+, D1.A, DRIVER1.2, FDC1.2, FDC2.2, IC1.7 (VCC), IC2.3 (VO), ISP.2, LED1.A, USART.4
ALIM_MPP: C1.+, D2.A, DRIVER1.8, SW1.3
AVCC: IC1.20 (AVCC)
DIR: DRIVER2.1, IC1.23 (PC0(ADC0))
FDC1: FDC2.1, IC1.4 (PD2(INT0)), R2.1
FDC2: FDC1.1, IC1.5 (PD3(INT1)), R3.1
GND: C1.-, C2.-, C3.-, C4.-, DRIVER1.1, DRIVER1.7, DRIVER2.8, IC1.8 (GND), IC2.2 (GND), ISP.8, ISP.10, J1.1, R1.2, R2.2, R3.2, USART.1
MISO: IC1.18 (PB4(MISO)), ISP.9
MOSI: IC1.17 (PB3(MOSI/OC2)), ISP.1
MS1: DRIVER2.7, IC1.27 (PC4(ADC4/SDA))
MS2: DRIVER2.6, IC1.26 (PC3(ADC3))
MS3: DRIVER2.5, IC1.25 (PC2(ADC2))
unnamed: J1.2, SW1.2
unnamed: C3.+, D1.C, D2.C, IC2.1 (VI)
unnamed: LED1.K (C), R1.1
unnamed: DRIVER2.3, DRIVER2.4
P1: DRIVER1.3, MPP.4
P2: DRIVER1.4, MPP.3
P3: DRIVER1.5, MPP.2
P4: DRIVER1.6, MPP.1
RST: IC1.1 (PC6(/RESET)), ISP.5
RX: IC1.2 (PD0(RXD)), USART.3
SCK: IC1.19 (PB5(SCK)), ISP.7
SRV: IC1.15 (PB1(OC1A))
STEP: DRIVER2.2, IC1.24 (PC1(ADC1))
TX: IC1.3 (PD1(TXD)), USART.2

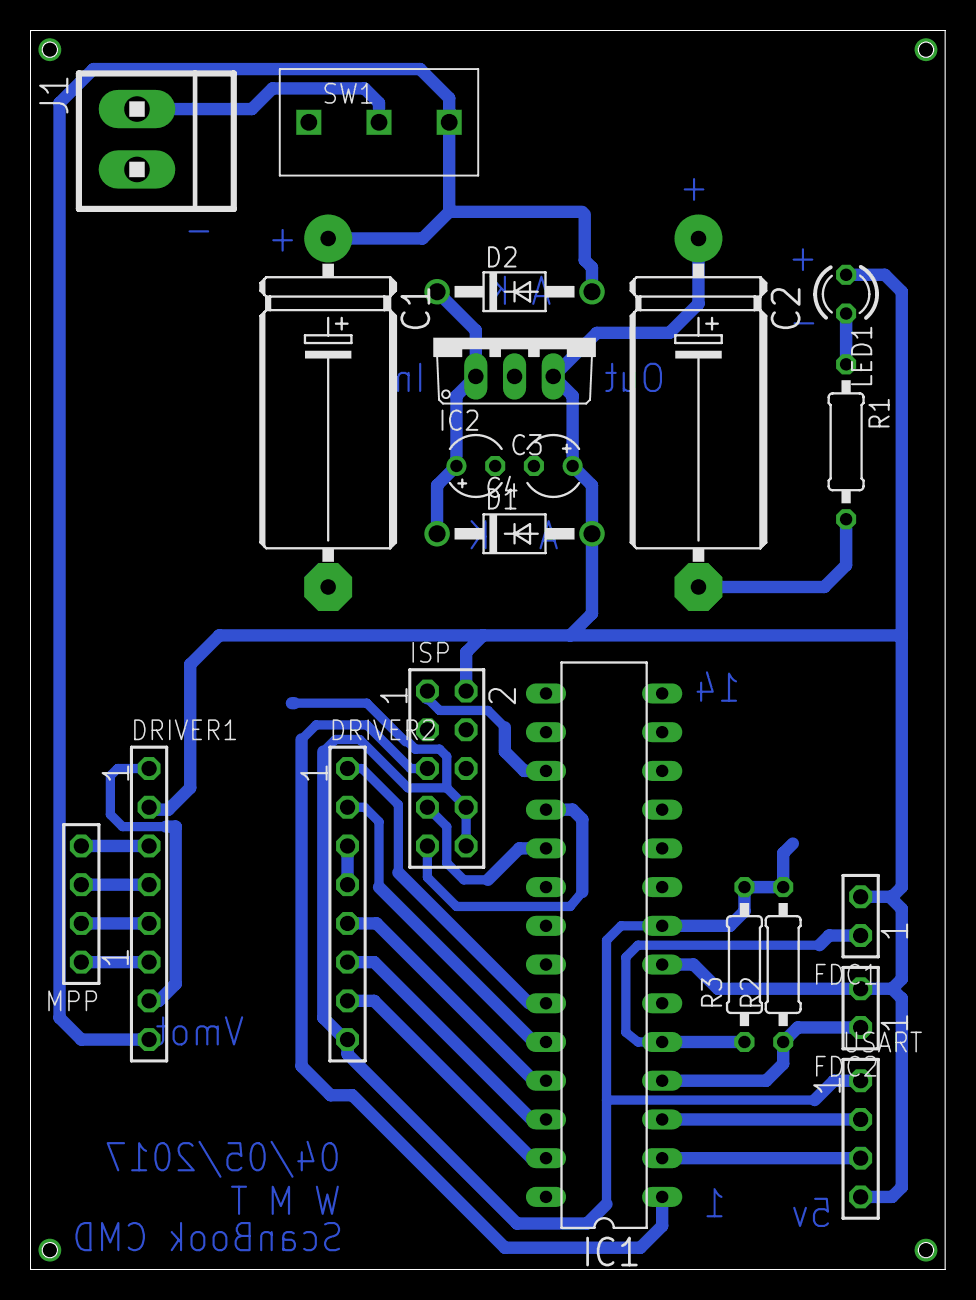
[picture p102: board ScanBook.brd from above]

Board: 2 copper layers, 60.0 x 81.3 mm, 21 parts (0 on the bottom side), 24 nets.
