ThomHPL/ScanBook_2017/Eagle/PiCam switch/PiCam_Switch_1.2.brd

## EAGLE design Eagle/PiCam switch/PiCam_Switch_1.2.brd (2017-05-15)

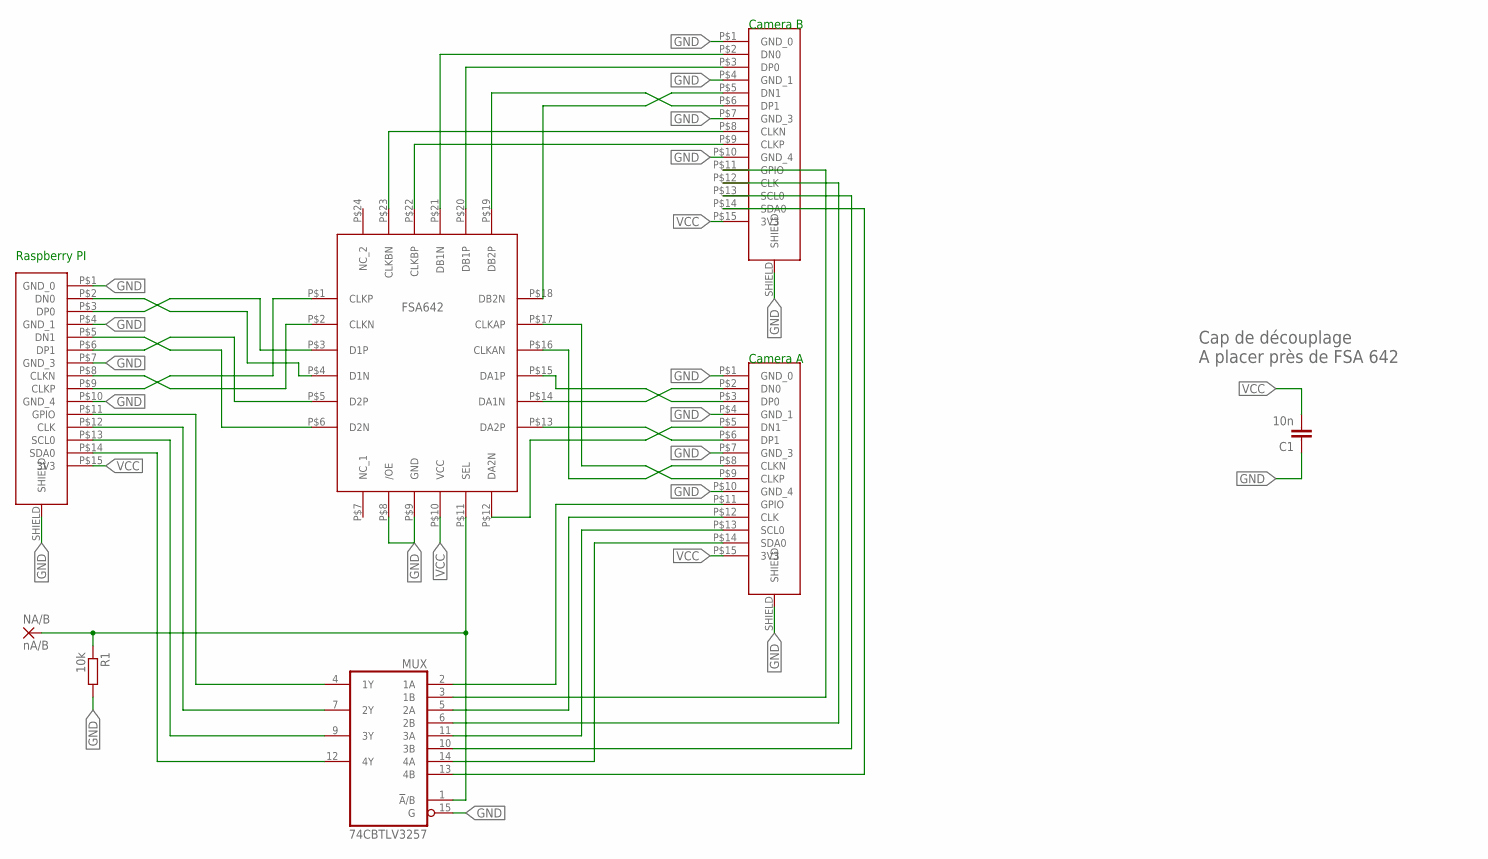
[picture p103: schematic PiCam_Switch_1.2.sch]

Parts:
C1: 10n; C1206
CAM_A: PICAM; FPC-CONN-15-SMD
CAM_B: PICAM; FPC-CONN-15-SMD
MUX: 74CBTLV3257; SO16
NA/B: nA/B; SMD1,27-2,54
R1: 10k; R1206
RPI: PICAM; FPC-CONN-15-SMD
U$1: FSA642; UMLP-24

Connections:
CLKA_N: CAM_A.P$8 (CLKN), U$1.P$16 (CLKAN)
CLKA_P: CAM_A.P$9 (CLKP), U$1.P$17 (CLKAP)
CLKB_N: CAM_B.P$8 (CLKN), U$1.P$23 (CLKBN)
CLKB_P: CAM_B.P$9 (CLKP), U$1.P$22 (CLKBP)
CLK_N: RPI.P$8 (CLKN), U$1.P$2 (CLKN)
CLK_P: RPI.P$9 (CLKP), U$1.P$1 (CLKP)
D0_N: RPI.P$2 (DN0), U$1.P$4 (D1N)
D0_P: RPI.P$3 (DP0), U$1.P$3 (D1P)
D1_N: RPI.P$5 (DN1), U$1.P$6 (D2N)
D1_P: RPI.P$6 (DP1), U$1.P$5 (D2P)
DA0_N: CAM_A.P$2 (DN0), U$1.P$14 (DA1N)
DA0_P: CAM_A.P$3 (DP0), U$1.P$15 (DA1P)
DA1_N: CAM_A.P$5 (DN1), U$1.P$12 (DA2N)
DA1_P: CAM_A.P$6 (DP1), U$1.P$13 (DA2P)
DB0_N: CAM_B.P$2 (DN0), U$1.P$21 (DB1N)
DB0_P: CAM_B.P$3 (DP0), U$1.P$20 (DB1P)
DB1_N: CAM_B.P$5 (DN1), U$1.P$18 (DB2N)
DB1_P: CAM_B.P$6 (DP1), U$1.P$19 (DB2P)
GND: C1.1, CAM_A.P$1 (GND_0), CAM_A.P$4 (GND_1), CAM_A.P$7 (GND_3), CAM_A.P$10 (GND_4), CAM_A.SHIELD, CAM_B.P$1 (GND_0), CAM_B.P$4 (GND_1), CAM_B.P$7 (GND_3), CAM_B.P$10 (GND_4), CAM_B.SHIELD, MUX.8 (GND), MUX.15 (G), R1.2, RPI.P$1 (GND_0), RPI.P$4 (GND_1), RPI.P$7 (GND_3), RPI.P$10 (GND_4), RPI.SHIELD, U$1.P$8 (/OE), U$1.P$9 (GND)
unnamed: MUX.1 (!A!/B), NA/B.1, R1.1, U$1.P$11 (SEL)
unnamed: MUX.4 (1Y), RPI.P$11 (GPIO)
unnamed: MUX.7 (2Y), RPI.P$12 (CLK)
unnamed: MUX.9 (3Y), RPI.P$13 (SCL0)
unnamed: MUX.12 (4Y), RPI.P$14 (SDA0)
unnamed: CAM_A.P$11 (GPIO), MUX.2 (1A)
unnamed: CAM_A.P$12 (CLK), MUX.5 (2A)
unnamed: CAM_A.P$13 (SCL0), MUX.11 (3A)
unnamed: CAM_A.P$14 (SDA0), MUX.14 (4A)
unnamed: CAM_B.P$11 (GPIO), MUX.3 (1B)
unnamed: CAM_B.P$12 (CLK), MUX.6 (2B)
unnamed: CAM_B.P$13 (SCL0), MUX.10 (3B)
unnamed: CAM_B.P$14 (SDA0), MUX.13 (4B)
VCC: C1.2, CAM_A.P$15 (3V3), CAM_B.P$15 (3V3), MUX.16 (VCC), RPI.P$15 (3V3), U$1.P$10 (VCC)

Notes on the sheet:
Raspberry PI
Camera A
Camera B
FSA642
Cap de découplage A placer près de FSA 642

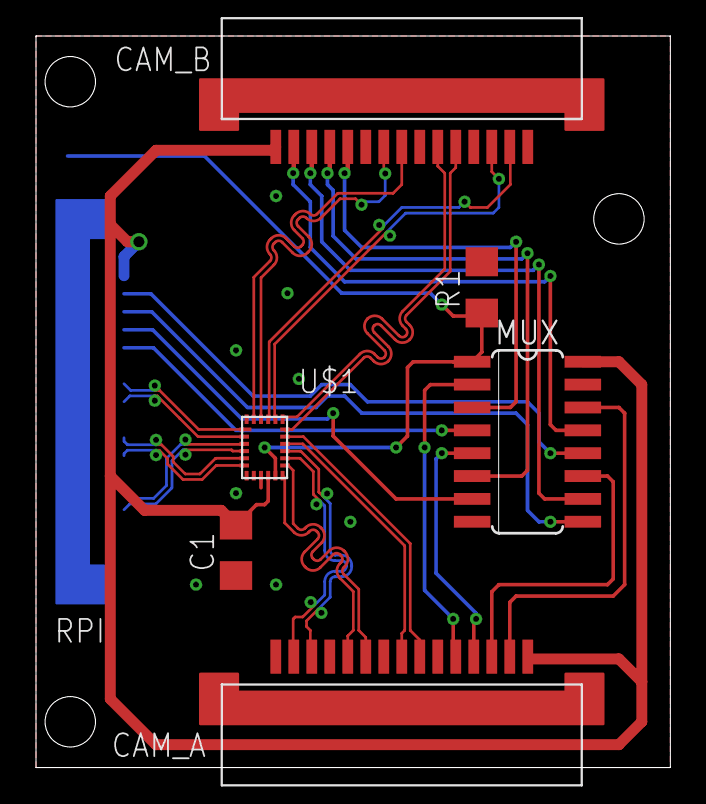
[picture p104: board PiCam_Switch_1.2.brd from above]

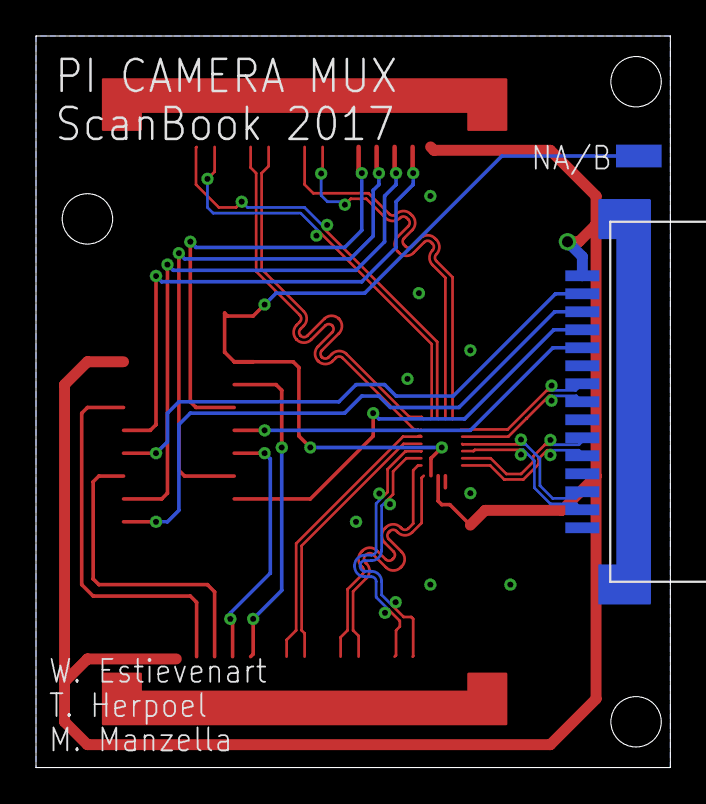
[picture p105: board PiCam_Switch_1.2.brd from below]

Board: 2 copper layers, 35.2 x 40.6 mm, 8 parts (2 on the bottom side), 33 nets.
