ThomHPL/ScanBook_2017/(commit log)

2017-02-07 ajout liste estimation des prix
2017-02-07 ajout list de references bilbio
2017-02-17 ajout du test camera 1.4
2017-03-08 ajout corner.stl
    [corner.stl]
2017-03-28 nouvelles pieces
    [bar_fix.stl, carriage_support.stl, spring_mecanism_A_L.stl, spring_mecanism_A_R.stl, spring_mecanism_B_L.stl, spring_mecanism_B_R.stl]
2017-04-10 cam switch
    [cam_support_A.stl, cam_support_B.stl]
2017-05-15 late commit...
    [PiCam_Switch_1.2.brd, PiCam_Switch_1.2.sch, ScanBook.brd, ScanBook.sch, circuit.brd, circuit.sch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]
